slhowe/Spiro/python/shuttering/shuttering_HFU_trial/images/IMG_20190321_174952.jpg

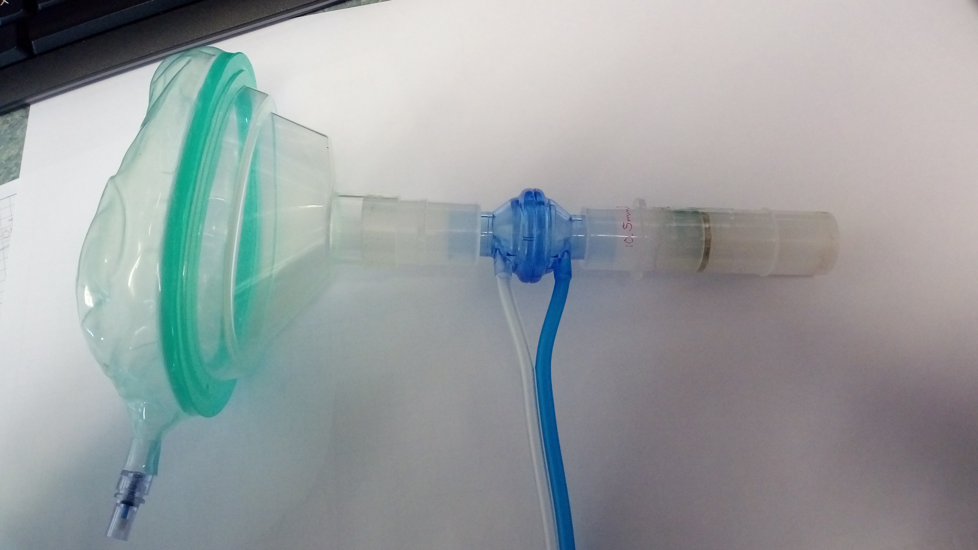
python/shuttering/shuttering_HFU_trial/images/IMG_20190321_174952.jpg
