slhowe/Spiro/spirometer_design/Spiro/spiroBoardV2/spiroBoardV2.html

# /home/sarah/Documents/Spirometry/spirometer_design/Spiro/spiroBoardV2/spiroBoardV2.sch

Tue 10 Sep 2019 03:00:49 PM NZST

Eeschema 5.1.4

Component Count:58

Ref | Qnty | Value | Part | Datasheet | Description | Vendor
C1 | 1 | 10n | Device:C | ~ | Unpolarized capacitor
C2 | 1 | 10uF | Device:C | ~ | Unpolarized capacitor
C3, C4 | 2 | 1uF | Device:C | ~ | Unpolarized capacitor
C5, C7, C8, C14, C15 | 5 | 0.1uF | Device:C | ~ | Unpolarized capacitor
C6 | 1 | 0.01uF | Device:C | ~ | Unpolarized capacitor
C9 | 1 | 22uF | Device:C | ~ | Unpolarized capacitor
C10, C11 | 2 | 100nF | Device:C | ~ | Unpolarized capacitor
C12, C13 | 2 | 22pF | Device:C | ~ | Unpolarized capacitor
Csuper1, Csuper2 | 2 | 1F | Device:CP1 | ~ | Polarized capacitor, US symbol
D1 | 1 | 3A 100V 0.4dV | Device:D | ~ | Diode
D2 | 1 | D_Schottky | Device:D_Schottky | ~ | Schottky diode
D3, D4 | 2 | LED | Device:LED | ~ | Light emitting diode
FB1, FB2 | 2 | Ferrite_Bead | Device:Ferrite_Bead | ~ | Ferrite bead
H1, H2, H3, H4 | 4 | MountingHole | Mechanical:MountingHole | ~ | Mounting Hole without connection
J1 | 1 | Barrel_Jack_Switch | Connector:Barrel_Jack_Switch | ~ | DC Barrel Jack with an internal switch
J2 | 1 | USB_B_Mini | Connector:USB_B_Mini | ~ | USB Mini Type B connector
J3 | 1 | Screw_Terminal_01x02 | Connector:Screw_Terminal_01x02 | ~ | Generic screw terminal, single row, 01x02, script generated (kicad-library-utils/schlib/autogen/connector/)
J4 | 1 | Conn_01x18_Female | Connector:Conn_01x18_Female | ~ | Generic connector, single row, 01x18, script generated (kicad-library-utils/schlib/autogen/connector/)
J5 | 1 | Conn_02x03_Odd_Even | Connector_Generic:Conn_02x03_Odd_Even | ~ | Generic connector, double row, 02x03, odd/even pin numbering scheme (row 1 odd numbers, row 2 even numbers), script generated (kicad-library-utils/schlib/autogen/connector/)
JP1 | 1 | Jumper_2_Bridged | Jumper:Jumper_2_Bridged | ~ | Jumper, 2-pole, closed/bridged
L1 | 1 | L_Core_Iron | Device:L_Core_Iron | ~ | Inductor with iron core
NMOS1 | 1 | 2N7002 | Transistor_FET:2N7002 | https://www.fairchildsemi.com/datasheets/2N/2N7002.pdf | 0.115A Id, 60V Vds, N-Channel MOSFET, SOT-23
PSH1 | 1 | ASDXRRX001PDAA5 | solenoidParts:ASDXRRX001PDAA5
PSL1 | 1 | SSCSNBN001NDAA5 | solenoidParts:SSCSNBN001NDAA5
R1 | 1 | 0.067 | Device:R | ~ | Resistor
R2, R9, R10 | 3 | 1K | Device:R | ~ | Resistor
R3, R5 | 2 | 8 | Device:R | ~ | Resistor
R4 | 1 | 160 | Device:R | ~ | Resistor
R6 | 1 | 300 | Device:R | ~ | Resistor
R7, R8 | 2 | 22 | Device:R | ~ | Resistor
R11 | 1 | 220 | Device:R | ~ | Resistor
R12 | 1 | 10K | Device:R | ~ | Resistor
RL1 | 1 | 250k | Device:R | ~ | Resistor
SW1 | 1 | SW_Push_Open | Switch:SW_Push_Open | ~ | Push button switch, push-to-open, generic, two pins
SW2 | 1 | SW_Push | Switch:SW_Push | ~ | Push button switch, generic, two pins
U1 | 1 | INA168 | Amplifier_Current:INA168 | http://www.ti.com/lit/ds/symlink/ina138.pdf | High-Side Measurement Current Shunt Monitor, 60V, SOT-23-5
U2 | 1 | OPA340NA | Amplifier_Operational:OPA340NA | http://www.ti.com/lit/ds/symlink/opa340.pdf | Single Single-Supply, Rail-to-Rail Operational Amplifier, MicroAmplifier Series, SOT-23-5
U3 | 1 | ZTX690B-ND | solenoidParts:ZTX690B-ND
U4 | 1 | RT9261A-50GB | solenoidParts:RT9261A-50GB
U5 | 1 | ATmega32U4-MU | MCU_Microchip_ATmega:ATmega32U4-MU | http://ww1.microchip.com/downloads/en/DeviceDoc/Atmel-7766-8-bit-AVR-ATmega16U4-32U4_Datasheet.pdf | 16MHz, 32kB Flash, 2.5kB SRAM, 1kB EEPROM, USB 2.0, QFN-44
Y1 | 1 | 16MHz | Device:Crystal | ~ | Two pin crystal
