slhowe/Spiro/spirometer_design/NewFile2.csv

X | CH1 | CH2 | CH3 | Start | Increment
Sequence | Volt | Volt | Volt | -4.120000e-02 | 2.000000e-04
0 | 1.22e+01 | 1.20e+00 | -1.60e-01
1 | 1.18e+01 | 1.00e+00 | 8.00e-02
2 | 1.22e+01 | 1.20e+00 | 8.00e-02
3 | 1.18e+01 | 1.00e+00 | -1.60e-01
4 | 1.26e+01 | 1.20e+00 | 8.00e-02
5 | 1.14e+01 | 1.00e+00 | -1.60e-01
6 | 1.26e+01 | 1.20e+00 | -8.00e-02
7 | 1.16e+01 | 1.00e+00 | 8.00e-02
8 | 1.18e+01 | 1.20e+00 | 8.00e-02
9 | 1.22e+01 | 1.00e+00 | -1.60e-01
10 | 1.18e+01 | 1.20e+00 | -1.60e-01
11 | 1.22e+01 | 1.00e+00 | 8.00e-02
12 | 1.22e+01 | 1.00e+00 | 8.00e-02
13 | 1.18e+01 | 1.20e+00 | -1.60e-01
14 | 1.22e+01 | 1.20e+00 | 8.00e-02
15 | 1.18e+01 | 1.00e+00 | -1.60e-01
16 | 1.26e+01 | 1.20e+00 | 8.00e-02
17 | 1.14e+01 | 1.00e+00 | -1.60e-01
18 | 1.22e+01 | 1.20e+00 | 8.00e-02
19 | 1.18e+01 | 1.00e+00 | -1.60e-01
20 | 1.22e+01 | 1.00e+00 | 8.00e-02
21 | 1.18e+01 | 1.20e+00 | -1.60e-01
22 | 1.22e+01 | 1.20e+00 | 8.00e-02
23 | 1.18e+01 | 1.00e+00 | -1.60e-01
24 | 1.22e+01 | 1.20e+00 | 8.00e-02
25 | 1.16e+01 | 1.00e+00 | -1.60e-01
26 | 1.14e+01 | 1.20e+00 | -8.00e-02
27 | 1.26e+01 | 1.00e+00 | 8.00e-02
28 | 1.22e+01 | 1.20e+00 | -1.60e-01
29 | 1.18e+01 | 1.00e+00 | 8.00e-02
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
