slhowe/Spiro/python/shuttering/shuttering_HFU_trial/images/all_shutters.png

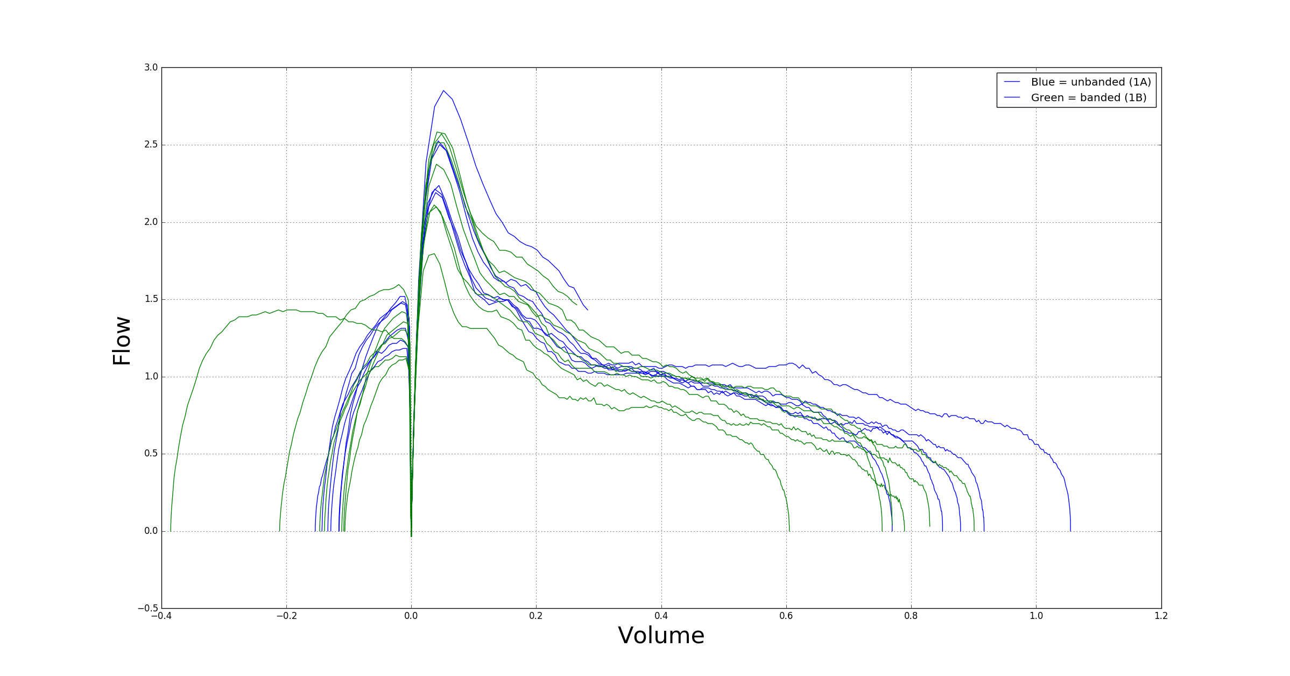
python/shuttering/shuttering_HFU_trial/images/all_shutters.png
