slhowe/Spiro/python/shuttering/shuttering_HFU_trial/images/all_shutters_norm.png

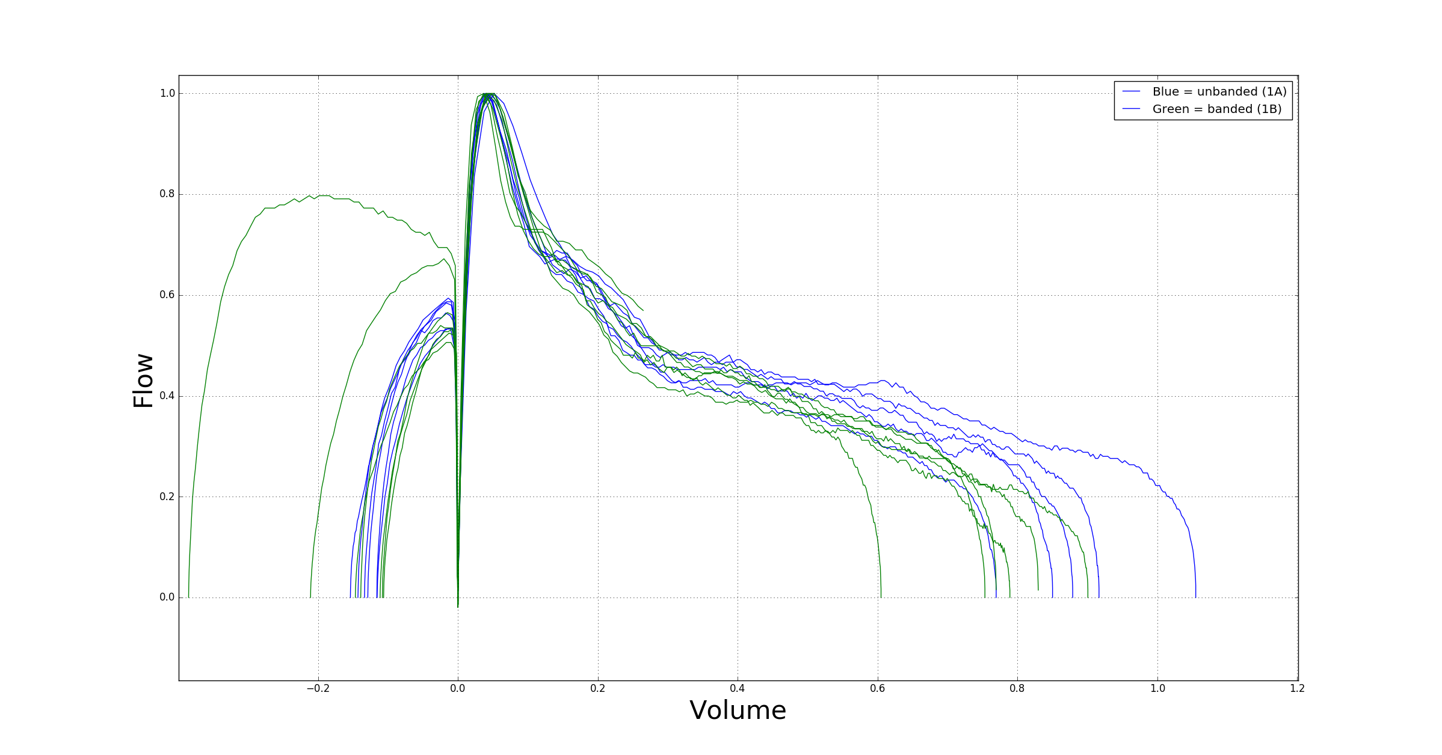
python/shuttering/shuttering_HFU_trial/images/all_shutters_norm.png
