slhowe/Spiro/python/shuttering/shuttering_HFU_trial/images/IMG_20190321_175017.jpg

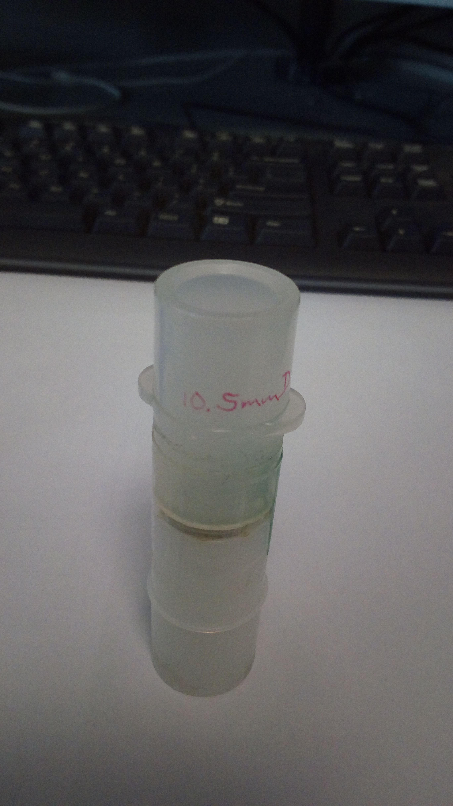
python/shuttering/shuttering_HFU_trial/images/IMG_20190321_175017.jpg
