slhowe/Spiro/python/shuttering/shuttering_HFU_trial/images/messy.png

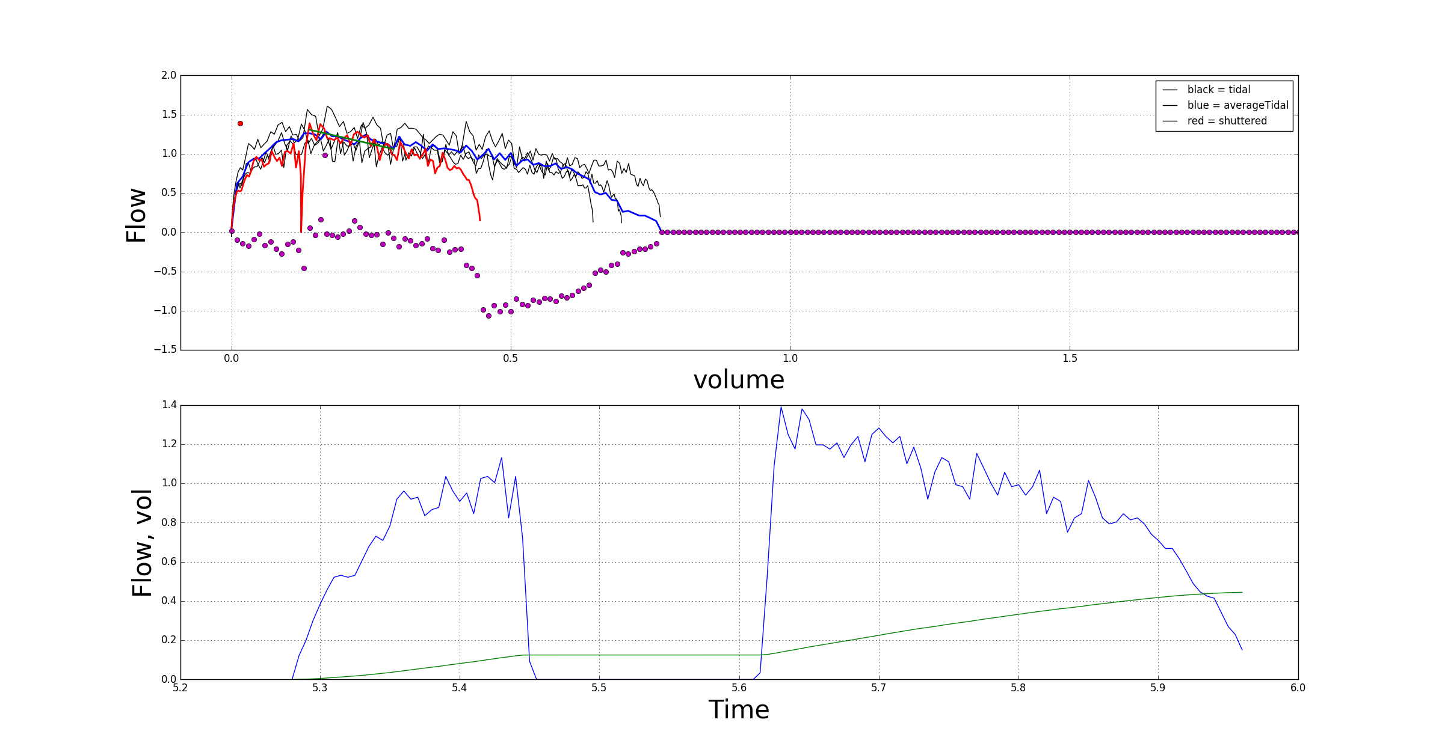
python/shuttering/shuttering_HFU_trial/images/messy.png
