slhowe/Spiro/python/shuttering/shuttering_HFU_trial/images/missingVolume.png

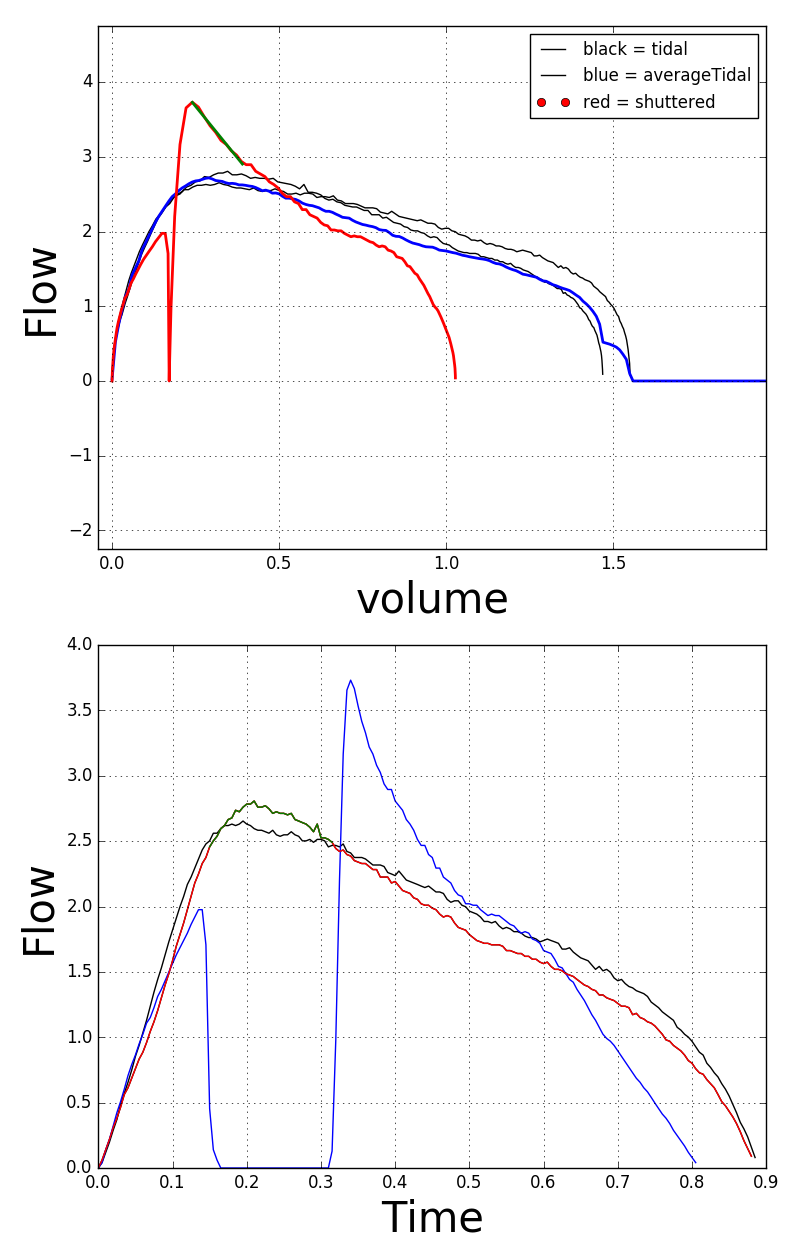
python/shuttering/shuttering_HFU_trial/images/missingVolume.png
