slhowe/Spiro/python/shuttering/shuttering_HFU_trial/images/nice.png

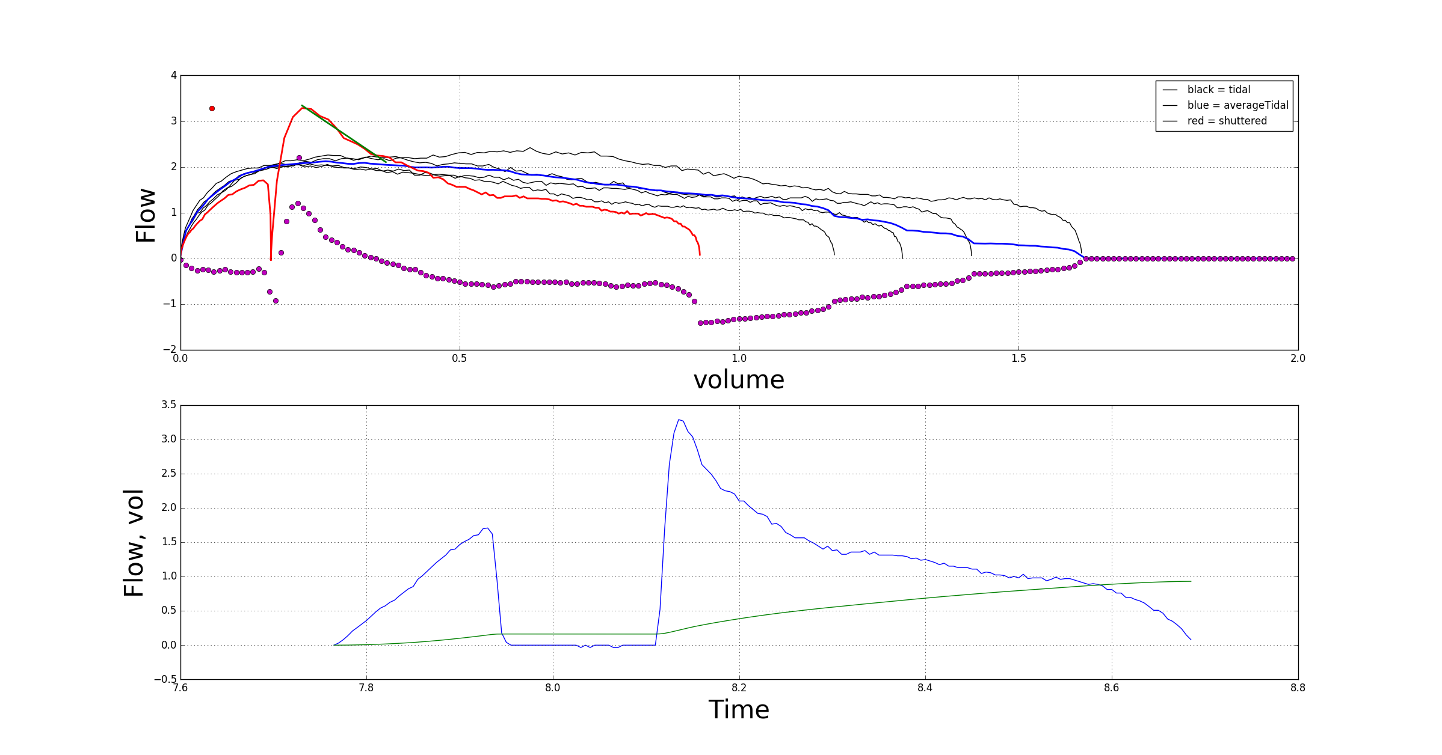
python/shuttering/shuttering_HFU_trial/images/nice.png
