slhowe/Spiro/python/shuttering/shuttering_HFU_trial/images/plethysmography_sparce.png

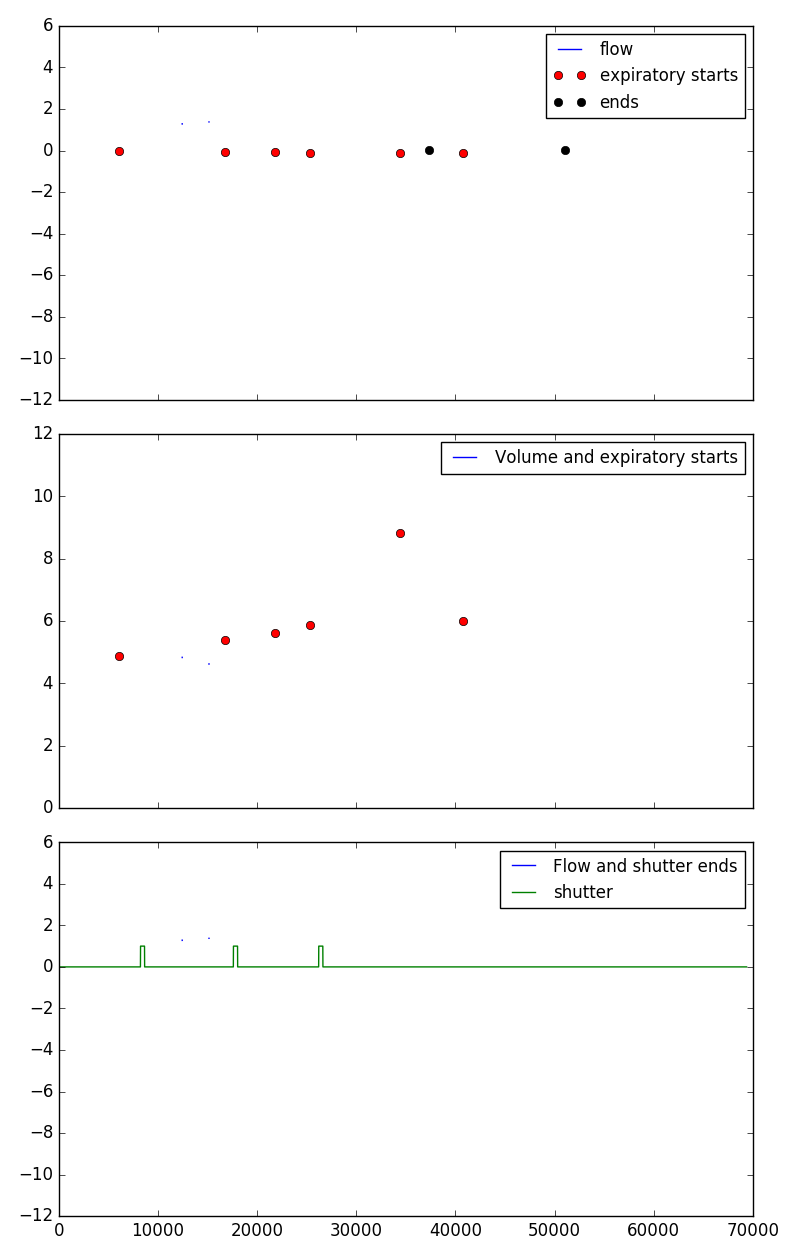
python/shuttering/shuttering_HFU_trial/images/plethysmography_sparce.png
