slhowe/Spiro/python/shuttering/shuttering_HFU_trial/images/shutter_example2.png

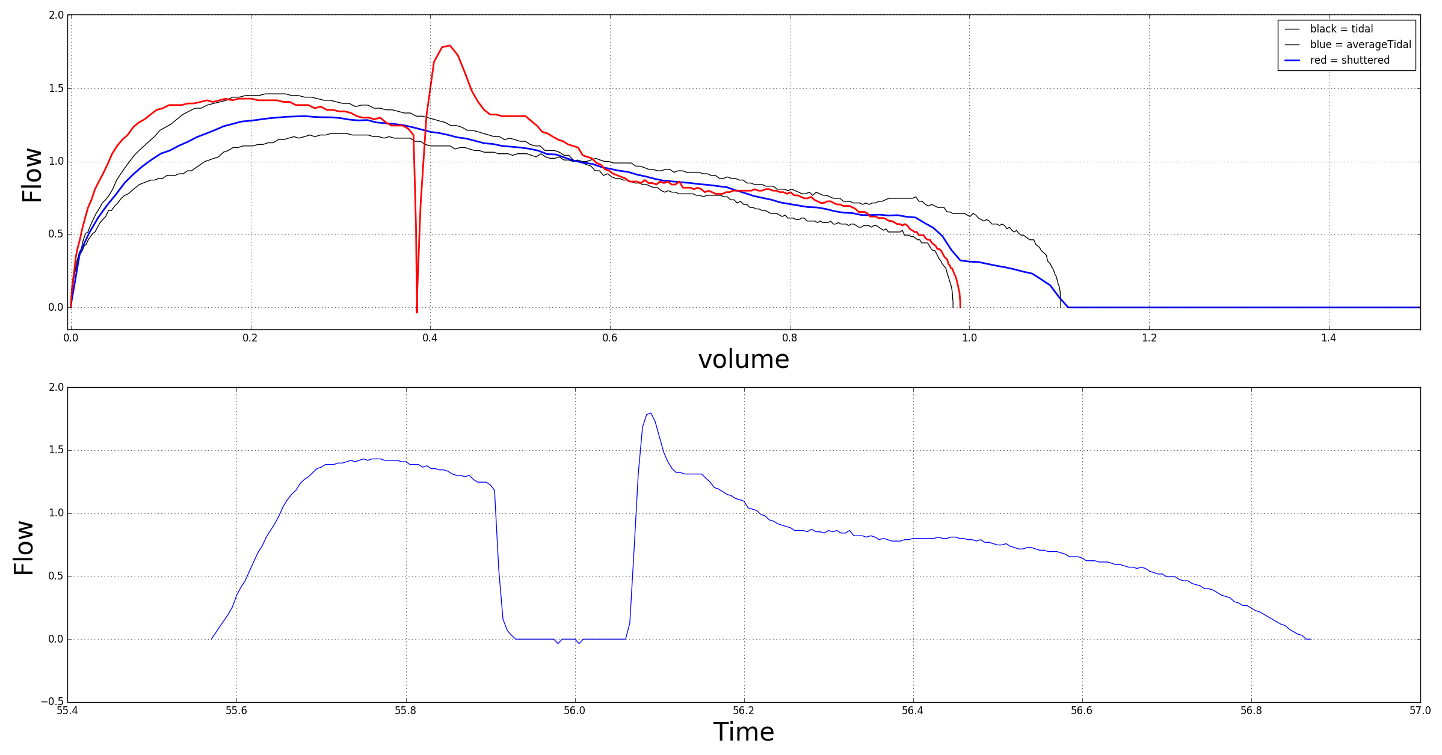
python/shuttering/shuttering_HFU_trial/images/shutter_example2.png
