slhowe/Spiro/python/shuttering/shuttering_HFU_trial/images/shutter_example3.png

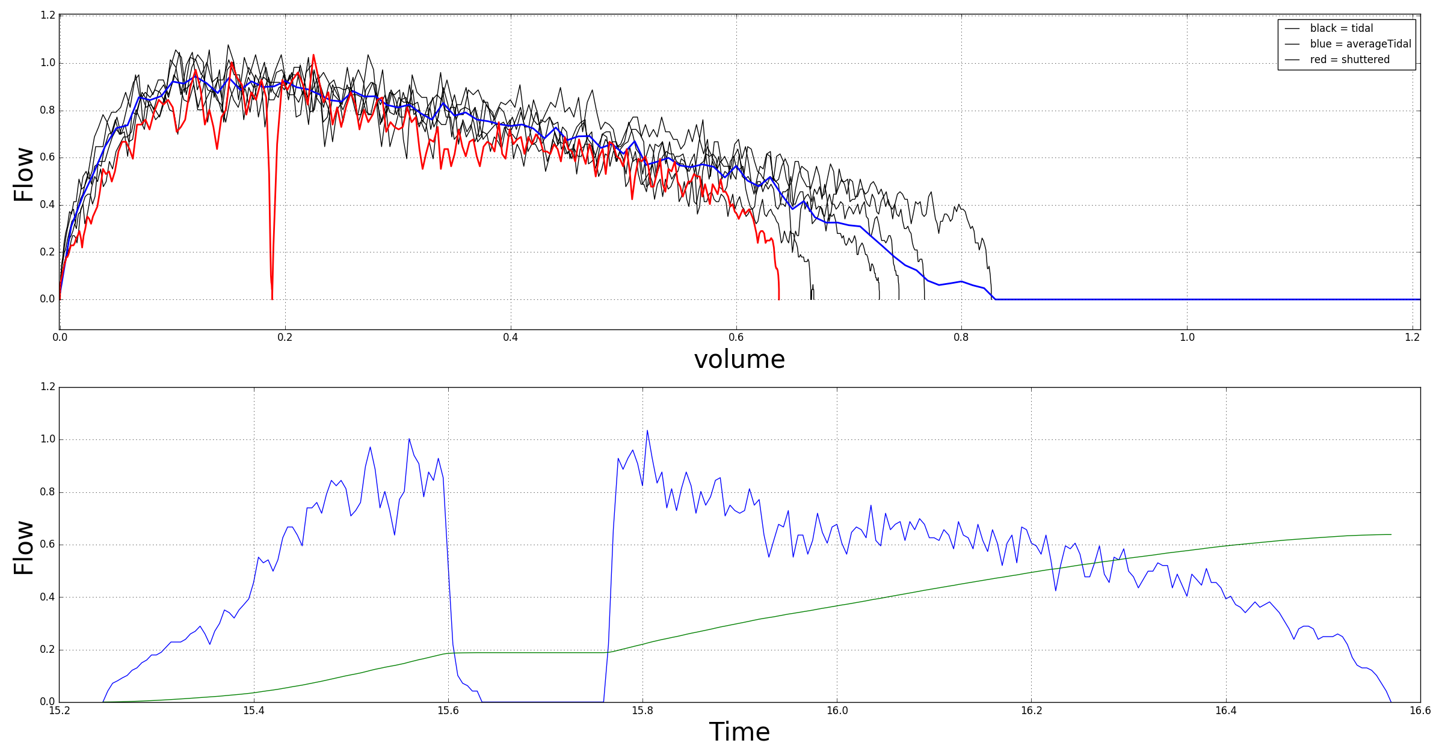
python/shuttering/shuttering_HFU_trial/images/shutter_example3.png
