slhowe/Spiro/python/shuttering/shuttering_HFU_trial/images/shutter_example.png

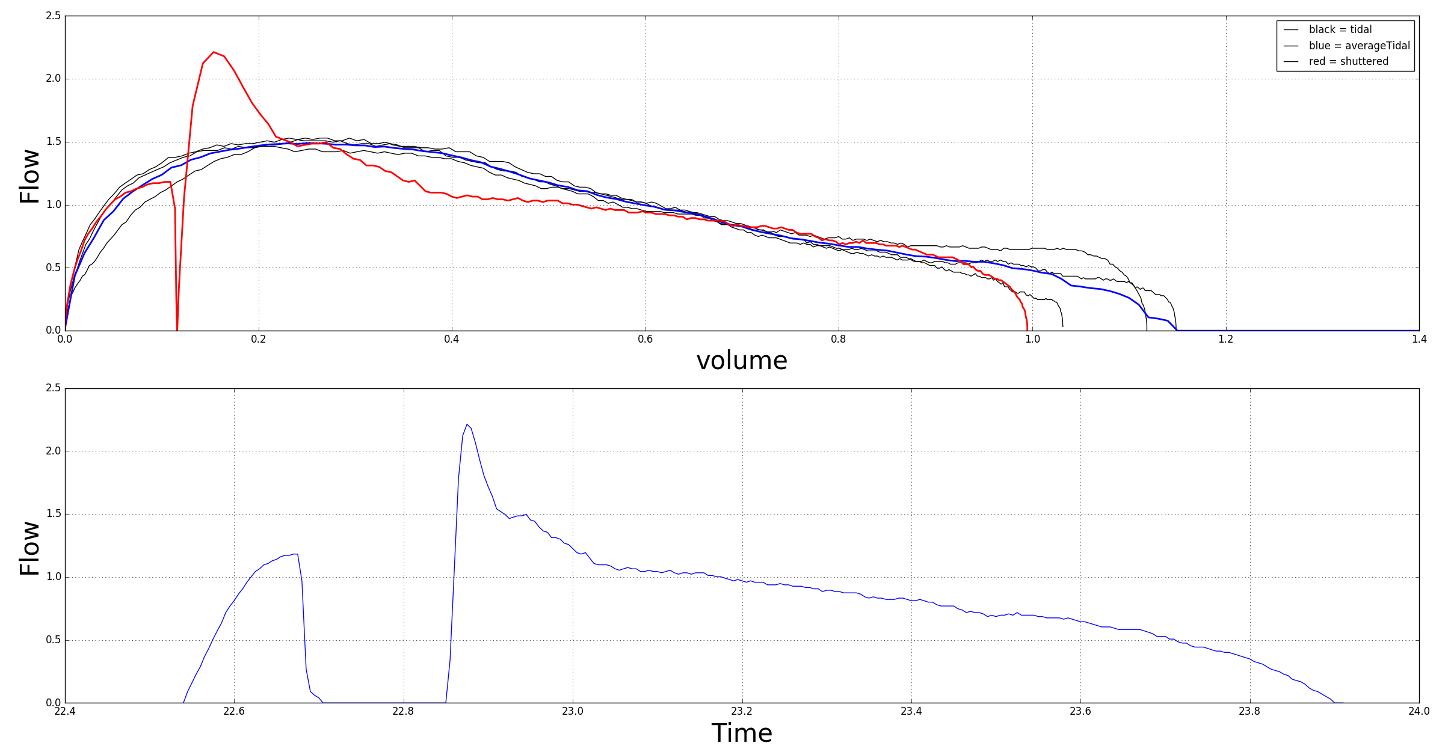
python/shuttering/shuttering_HFU_trial/images/shutter_example.png
