slhowe/Spiro/python/shuttering/simulation/QV_loops.png

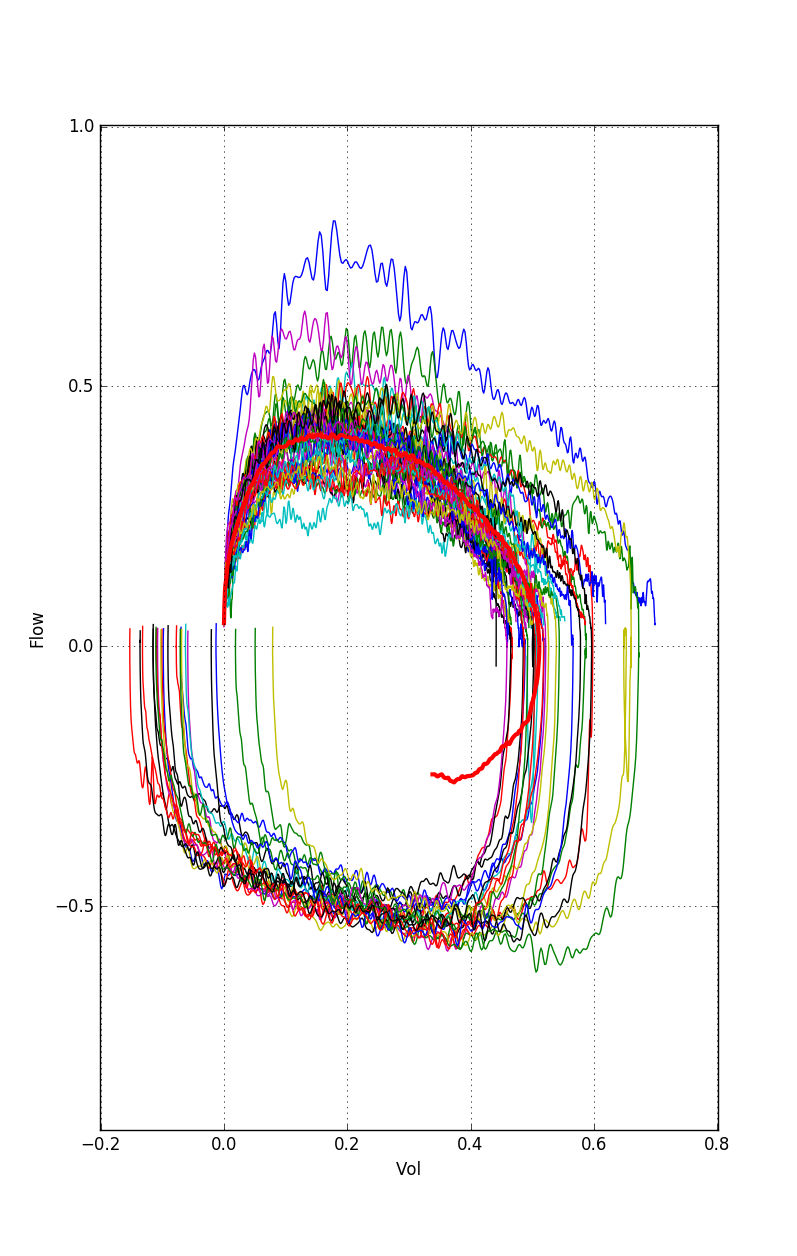
python/shuttering/simulation/QV_loops.png
