slhowe/Spiro/spirometer_design/jake_small/digQuote.xls

Digi-Key Part Number | Manufacturer | Manufacturer Part Number | Description | Customer Reference | Quantity 1 | Price | Comp total | Quantity 2 | Price | Comp total | Quantity 3 | Price | Comp total | Stock Status | Mfg Std Lead Time | Comments | RoHS Status | Lead Free Status | REACH Status | US Tariff Status
ATTINY167-MU-ND | MICROCHIP TECHNOLOGY | ATTINY167-MU | IC MCU 8BIT 16KB FLASH 32VQFN |  | 2 | 1.57 | 3.14 | 10 | 1.57 | 15.7 | 50 | 1.4316 | 71.58 | IN STOCK | 4 Weeks | Alternate Packaging Exists | RoHS Compliant | Lead free | Unaffected Jan-2017
SAM9428-ND | SAMTEC INC | FTSH-104-01-F-DV | .050" X .050 TERMINAL STRIP |  | 4 | 1.36 | 5.44 | 20 | 1.235 | 24.7 | 100 | 1.235 | 123.5 | IN STOCK | 3 Weeks | Alternate Packaging Exists | RoHS Compliant | Lead free | Unaffected Jan-2017
1497-1371-1-ND | SUNLED COMPANY LLC (VA) | XZM2MRTNI55W-8 | LED RED CLEAR 4SMD |  | 8 | 1.42 | 11.36 | 40 | 0.8844 | 35.376 | 200 | 0.7961 | 159.22 | IN STOCK | 6 Weeks | Alternate Packaging Exists | RoHS Compliant | Lead free | Unaffected Jan-2017 | Tariff Applied
160-1827-1-ND | LITE-ON INC (VA) | LTST-C193TBKT-5A | LED BLUE CLEAR CHIP SMD |  | 2 | 0.17 | 0.34 | 10 | 0.336 | 3.36 | 50 | 0.2572 | 12.86 | IN STOCK | 12 Weeks | Alternate Packaging Exists | RoHS Compliant | Lead free | Not Available | Tariff Applied
1276-1012-1-ND | SAMSUNG ELECTRO-MECHANICS AMERICA, INC (VA) | CL10F104ZB8NNNC | CAP CER 0.1UF 50V Y5V 0603 |  | 2 | 0.1 | 0.2 | 10 | 0.038 | 0.38 | 50 | 0.038 | 1.9 | 1692092 IN STOCK/NO DELIVERY DATE AVAILABLE | 62 Weeks | No delivery date available | RoHS Compliant | Lead free | Unaffected Jul-2017
478-1556-1-ND | AVX CORPORATION (VA) | 12065C104KAT2A | CAP CER 0.1UF 50V X7R 1206 |  | 2 | 0.3 | 0.6 | 10 | 0.205 | 2.05 | 50 | 0.205 | 10.25 | IN STOCK | 30 Weeks | Alternate Packaging Exists | RoHS Compliant | Lead free | Unaffected Jul-2017 | Tariff Applied
A106145CT-ND | TE CONNECTIVITY AMP (VA) | RCU-0C | PC TEST POINT NATURAL |  | 4 | 0.22 | 0.88 | 20 | 0.211 | 4.22 | 100 | 0.1462 | 14.62 | IN STOCK | 7 Weeks | Alternate Packaging Exists | RoHS Compliant | Lead free | Not Available
P300LCT-ND | PANASONIC ELECTRONIC COMPONENTS (VA) | ERJ-2RKF3000X | RES SMD 300 OHM 1% 1/10W 0402 |  | 2 | 0.1 | 0.2 | 10 | 0.054 | 0.54 | 50 | 0.054 | 2.7 | IN STOCK | 18 Weeks | Alternate Packaging Exists | RoHS Compliant | Lead free | Unaffected Jan-2017 | Tariff Applied
P115DBCT-ND | PANASONIC ELECTRONIC COMPONENTS (VA) | ERA-3AEB1150V | RES SMD 115 OHM 0.1% 1/10W 0603 | R5, R7 | 4 | 0.35 | 1.4 | 20 | 0.3 | 6 | 100 | 0.1172 | 11.72 | IN STOCK | 23 Weeks | Alternate Packaging Exists | RoHS Compliant | Lead free | Unaffected Jan-2017
P69.8DBCT-ND | PANASONIC ELECTRONIC COMPONENTS (VA) | ERA-3AEB69R8V | RES SMD 69.8 OHM 0.1% 1/10W 0603 | R6, R9 | 4 | 0.35 | 1.4 | 20 | 0.3 | 6 | 100 | 0.1172 | 11.72 | IN STOCK | 23 Weeks | Alternate Packaging Exists | RoHS Compliant | Lead free | Unaffected Jan-2017
 |  |  |  |  |  | Total: | 24.96 |  | Total: | 98.326 |  | Total: | 420.07
 |  |  |  |  |  | $/board | 12.48 |  | $/board | 9.8326 |  | $/board | 8.4014
 |  |  |  |  |  |  | 200 | 0.7961 | 159.22
 |  |  |  |  |  |  | 350 | 0.70768 | 247.688
