slhowe/Spiro/spirometer_design/jake_small/jake_small_holder.stl

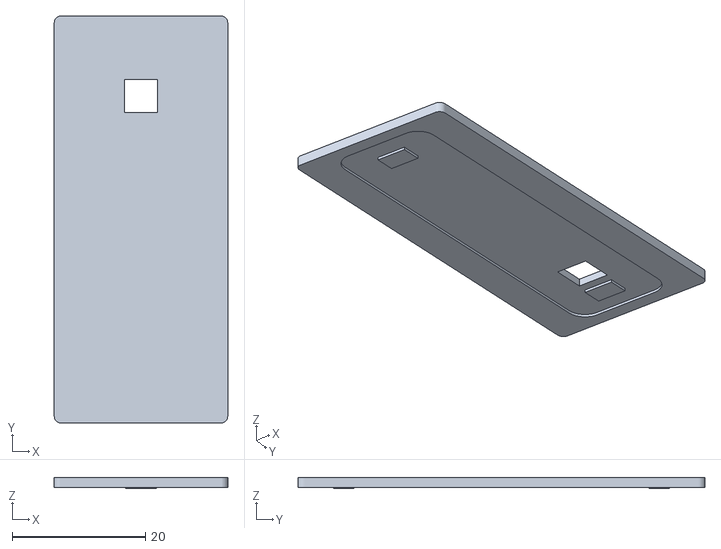
[picture p14: CAD file, 2020-03-23]
spirometer_design/jake_small/jake_small_holder.stl
26.0 x 61.0 x 1.70
