slhowe/Spiro/spirometer_design/jake_small/jake_small_holder.scad

bX = 13;
bY = 54;

holeX = 8;
holeY = 3.5;

dHoleY = 47;

roundedRect([bX, bY, 0.4], 2.5);
module roundedRect(size, radius)
{
x = size[0];
y = size[1];
z = size[2];

linear_extrude(height=z)
hull()
{
    // place 4 circles in the corners, with the given radius
    translate([(-x/2)+(radius/2), (-y/2)+(radius/2), 0])
    circle(r=radius);

    translate([(x/2)-(radius/2), (-y/2)+(radius/2), 0])
    circle(r=radius);

    translate([(-x/2)+(radius/2), (y/2)-(radius/2), 0])
    circle(r=radius);

    translate([(x/2)-(radius/2), (y/2)-(radius/2), 0])
    circle(r=radius);
}

}
