slhowe/Spiro/python/shuttering/shuttering_HFU_trial/data/HFU_Respiratory_Trial/P1-JGC-18032019/Test Sequence Run Sheet ver 1.0.xlsx

Sheet: Run Ver 1A
Test sequence run sheet
Baseline: steady breathing to get FRC and Rspecific resistance
Standard-XX: Forced expiration tests of N=3 good examples with additions as noted. Yields FEV1 and FVC as well
Shutter-XX: Normal breathing with 150ms shuttering in expiration (1st second) as only speed possible, with additions as noted
Additions: band and/or added resistance
 |  |  | = added resistance
 |  |  | = nominal resistance
 |  |  |  | = nominal compliance
 |  |  |  | = added band and reduced compliance
 | Baseline
 | Standard-1A | no additions
 | Baseline
 | Standard-1B | with band
 | Baseline
 | Standard-2A | with band and added resistance
 | Baseline
 | Standard-2B | added resistance
 | Baseline
 | Shutter-2B | with added resistance
 | Baseline
 | Shutter-2A | with band and added resistance
 | Baseline
 | Shutter-1B | with band
 | Baseline
 | Shutter-1A | no additions

Sheet: Run Ver 1B
Test sequence run sheet
Baseline: steady breathing to get FRC and Rspecific resistance
Standard-XX: Forced expiration tests of N=3 good examples with additions as noted. Yields FEV1 and FVC as well
Shutter-XX: Normal breathing with 150ms shuttering in expiration (1st second) as only speed possible, with additions as noted
Additions: band and/or added resistance
 |  |  | = added resistance
 |  |  | = nominal resistance
 |  |  |  | = nominal compliance
 |  |  |  | = added band and reduced compliance
 | Baseline
 | Standard-1A | no additions
 | Baseline
 | Shutter-1A | no additions
 | Baseline
 | Standard-1B | with band
 | Baseline
 | Shutter-1B | with band
 | Baseline
 | Standard-2A | with band and added resistance
 | Baseline
 | Shutter-2A | with band and added resistance
 | Baseline
 | Standard-2B | added resistance
 | Baseline
 | Shutter-2B | with added resistance
