slhowe/Spiro/python/calibration/calibrationFiles/flip_spir_1.png

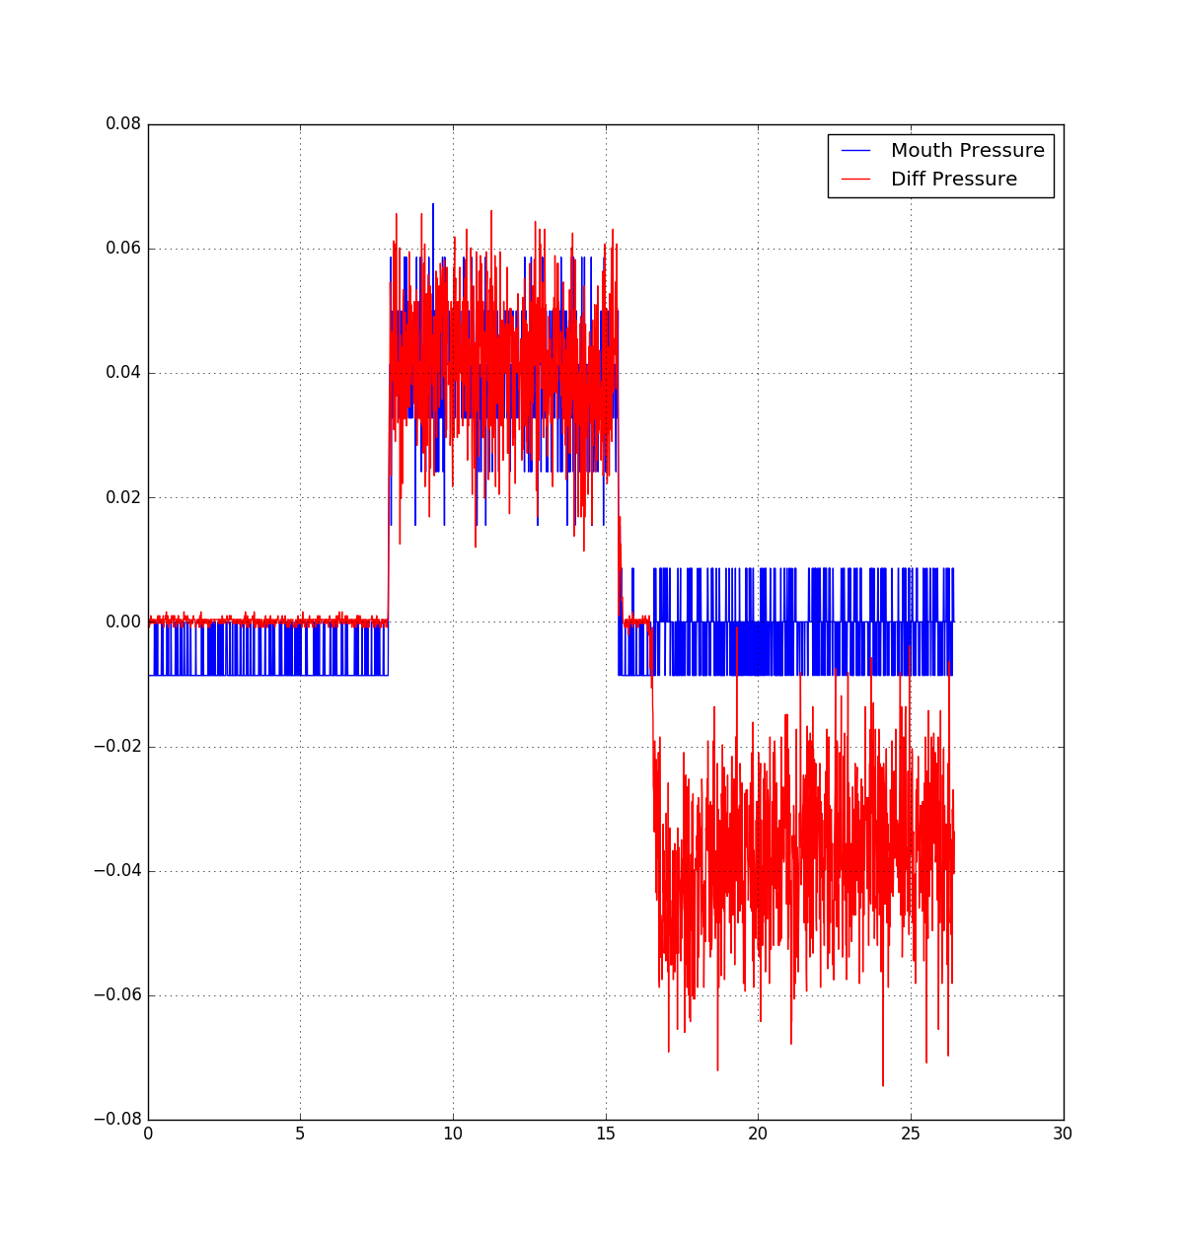
python/calibration/calibrationFiles/flip_spir_1.png
