slhowe/Spiro/python/calibration/calibrationFiles/flip_spir_2.png

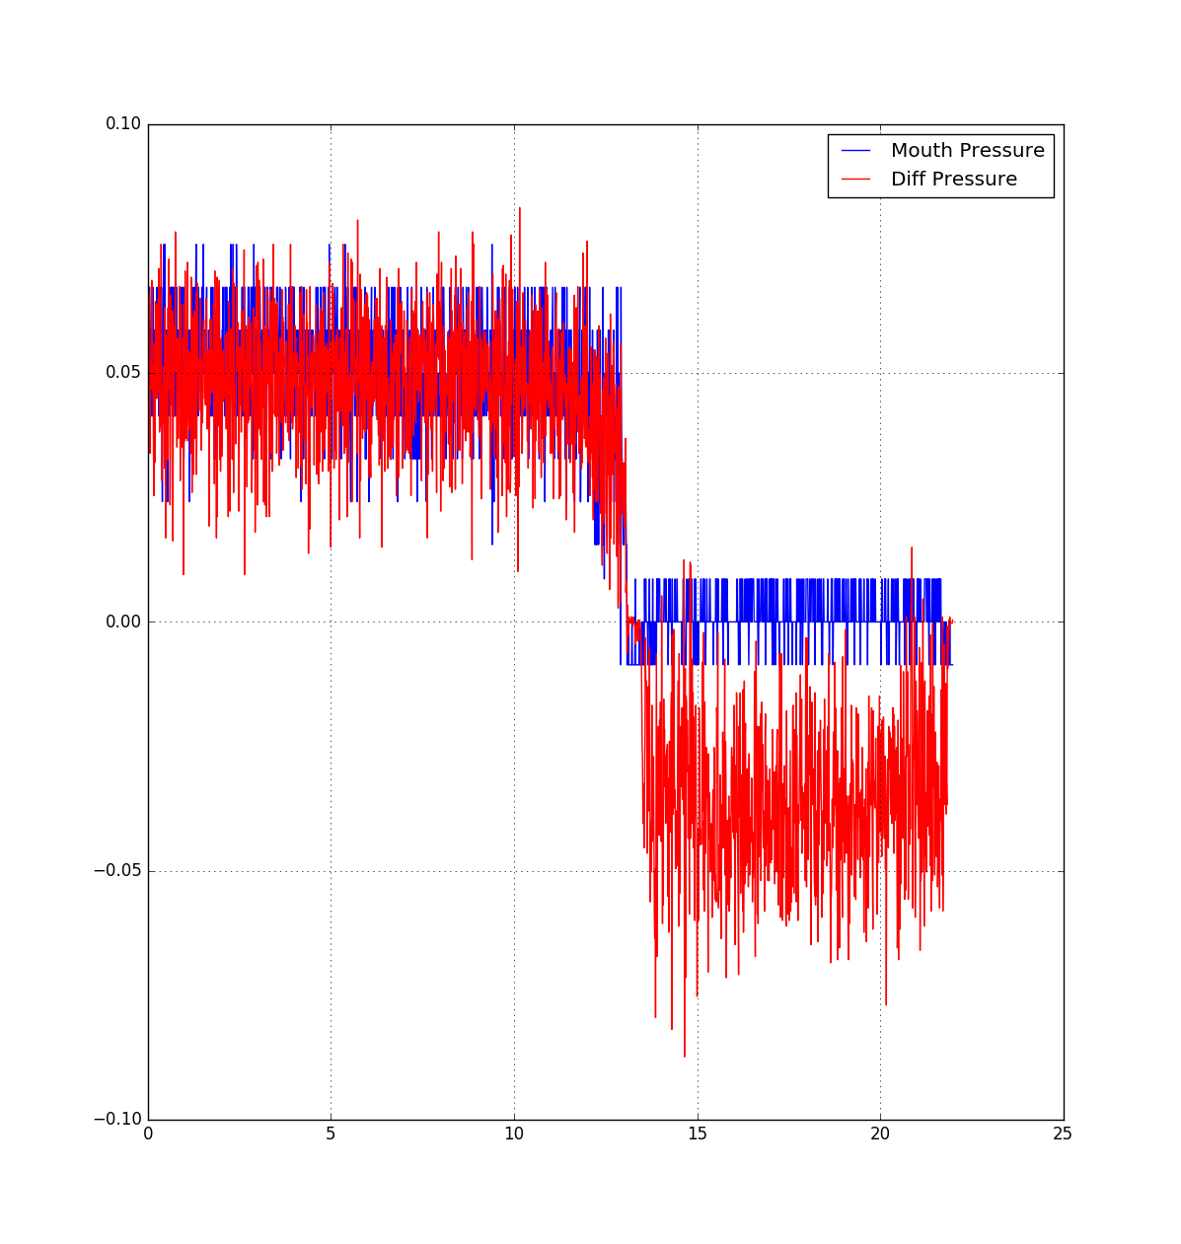
python/calibration/calibrationFiles/flip_spir_2.png
