slhowe/Spiro/python/calibration/calibrationFiles/flip_spir_3.png

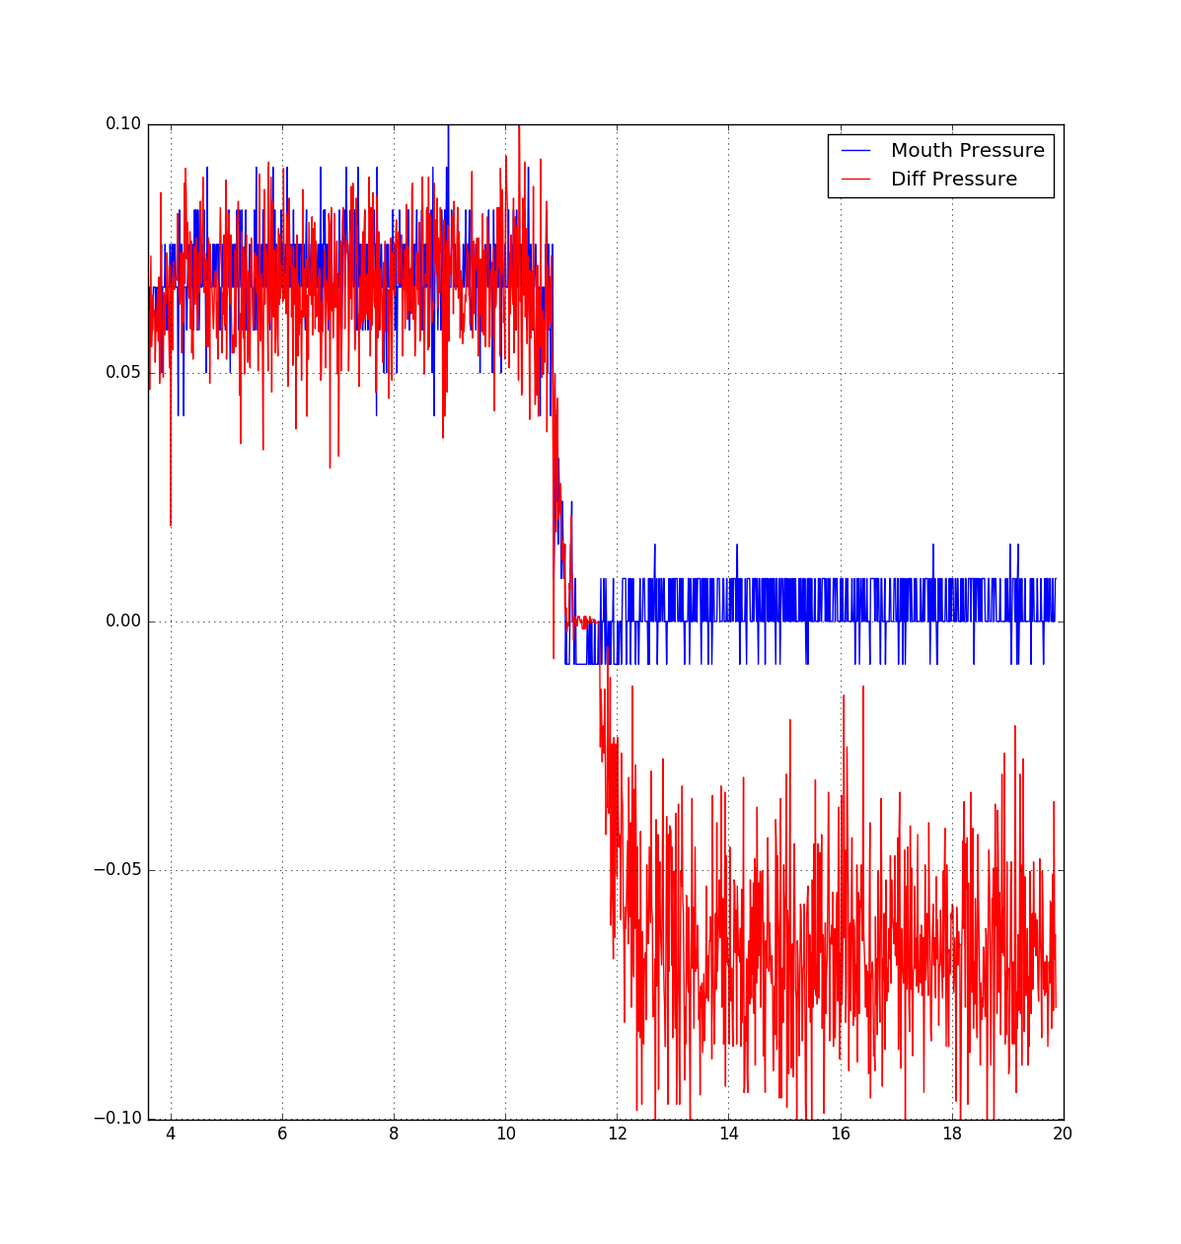
python/calibration/calibrationFiles/flip_spir_3.png
