slhowe/Spiro/python/shuttering/simulation/Germany_results_badfit.png

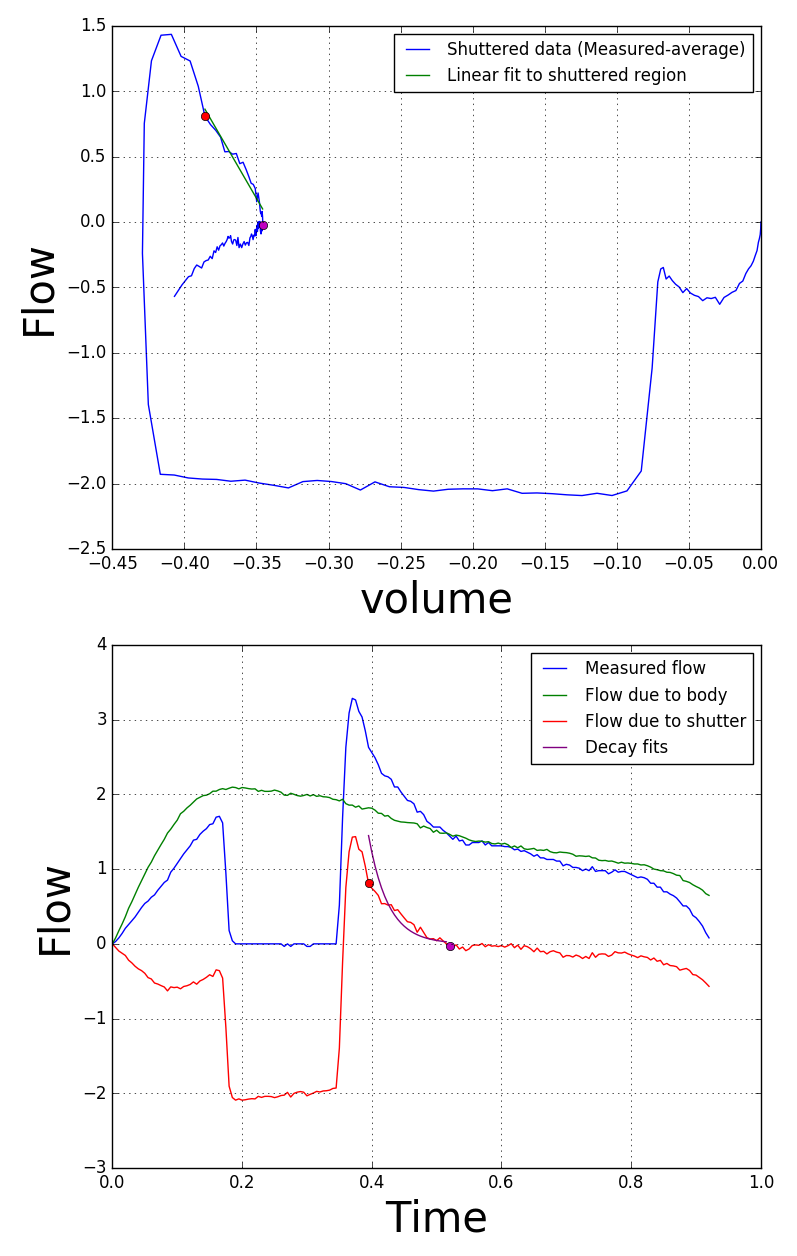
python/shuttering/simulation/Germany_results_badfit.png
