slhowe/Spiro/python/shuttering/simulation/Germany_results_betterfit.png

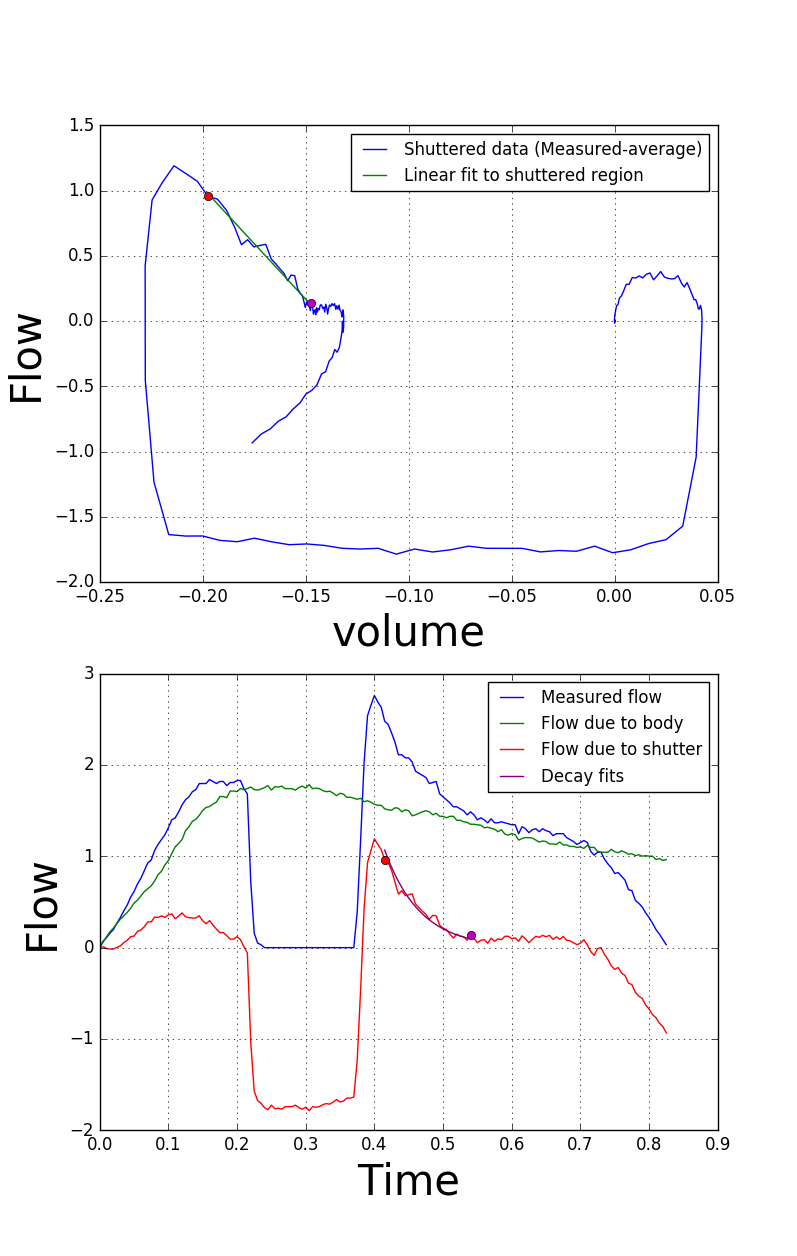
python/shuttering/simulation/Germany_results_betterfit.png
