slhowe/Spiro/python/shuttering/simulation/my_results.png

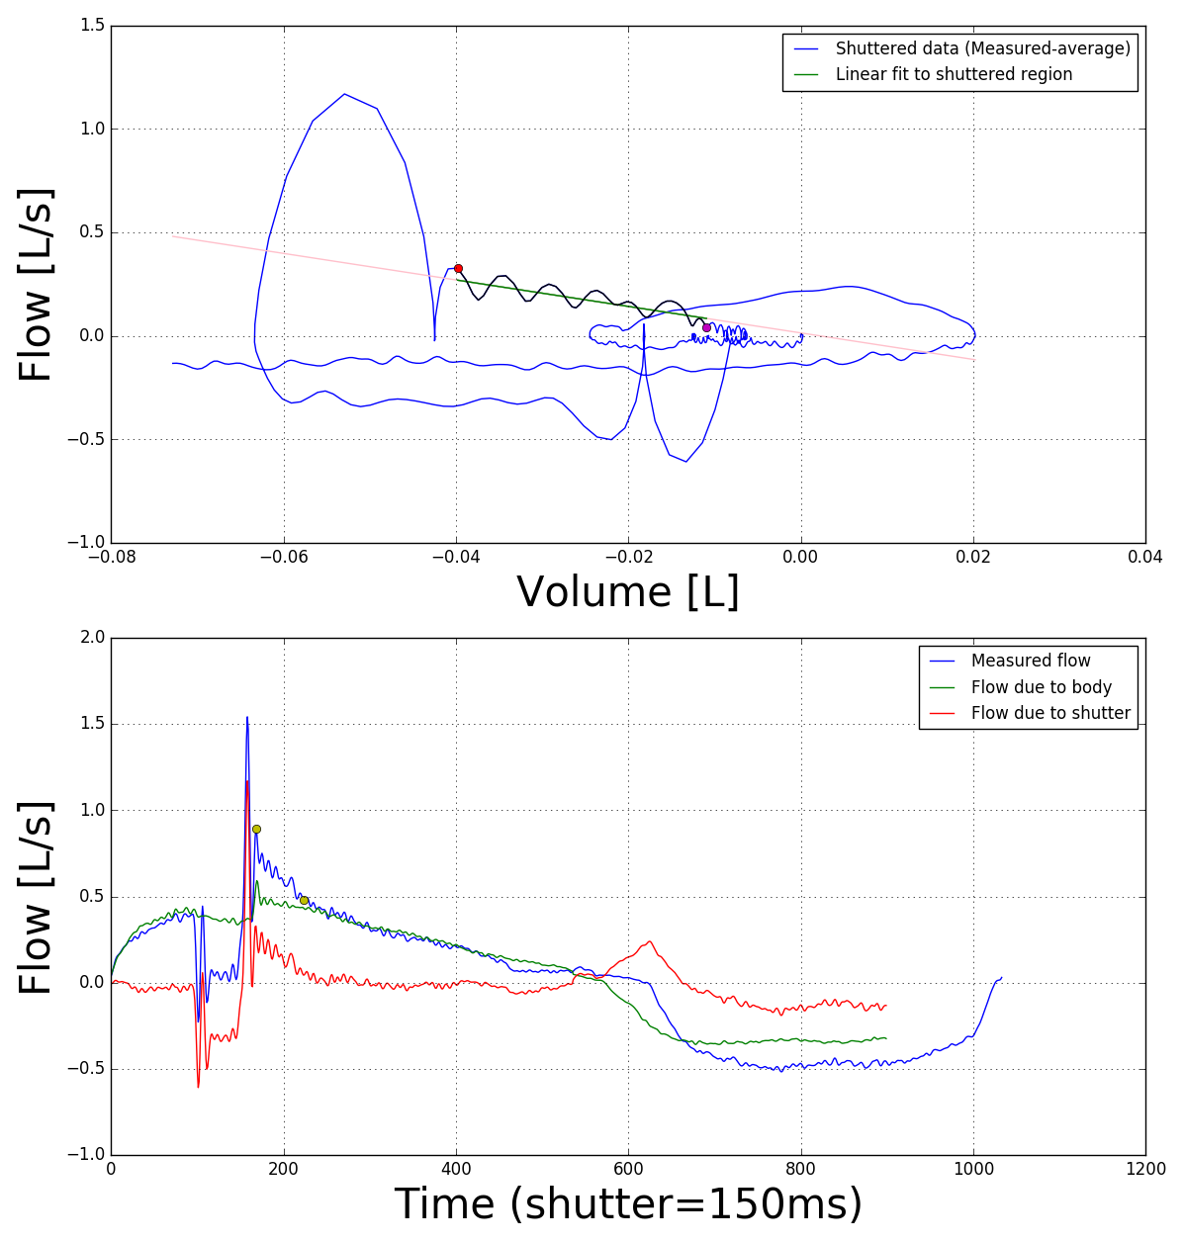
python/shuttering/simulation/my_results.png
