slhowe/Spiro/python/shuttering/simulation/Simulation_results.png

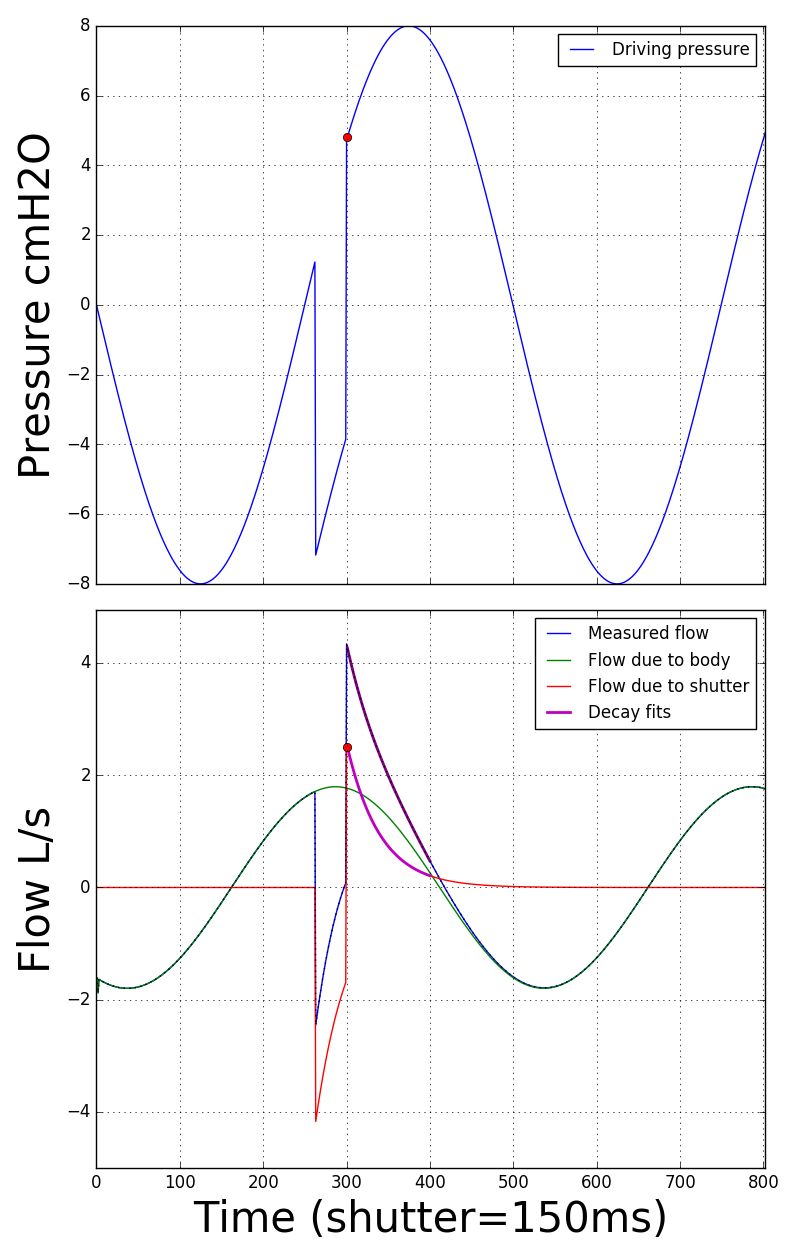
python/shuttering/simulation/Simulation_results.png
