slhowe/Spiro/python/shuttering/simulation/Simulation_results_QV.png

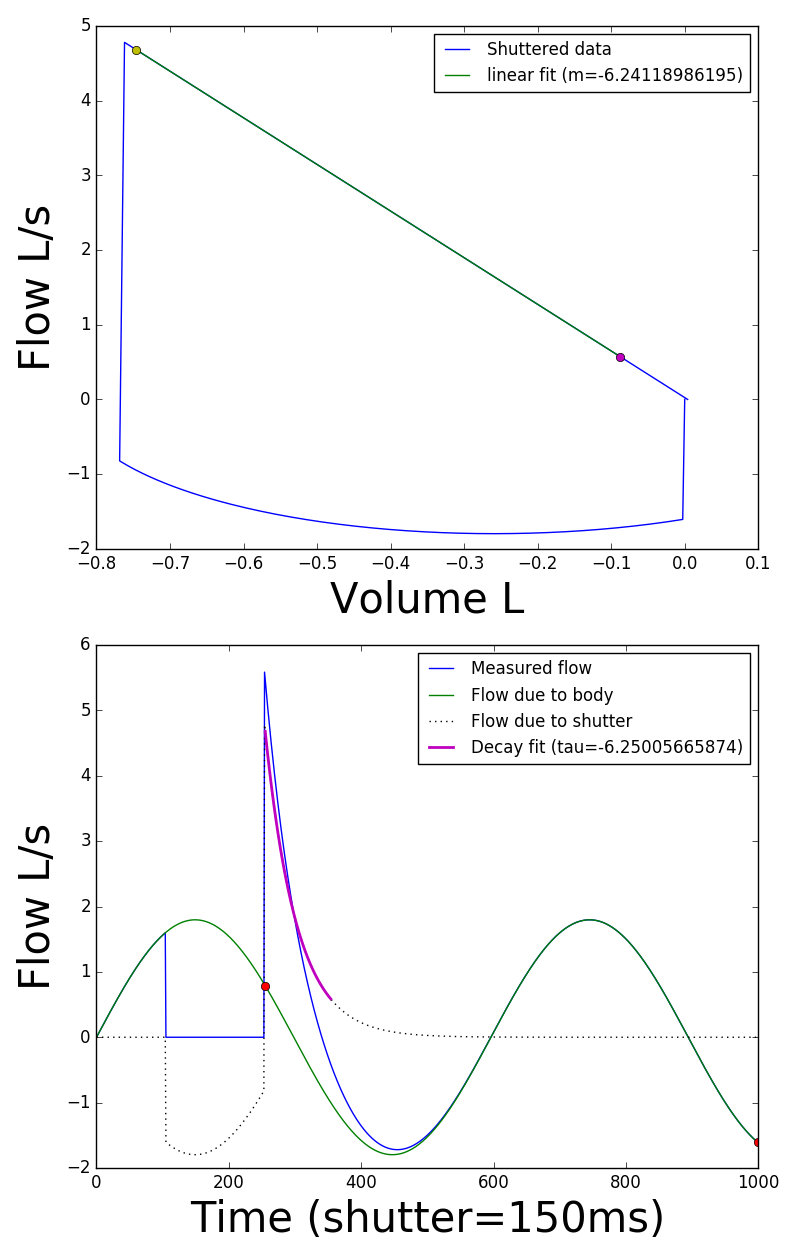
python/shuttering/simulation/Simulation_results_QV.png
