slhowe/Spiro/spirometer_design/jake_small/pdf/jake_small-F.SilkS.pdf

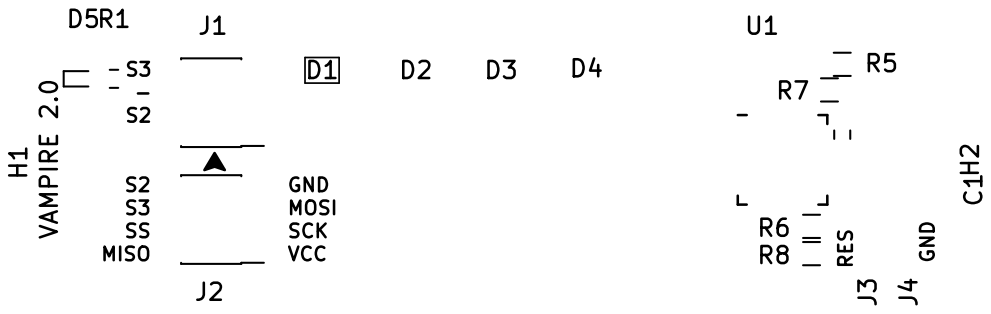
[picture p23: page 1]

RES GND D1 D2 D3 D4 GND MOSI SCK
