slhowe/Spiro/spirometer_design/jake_small/pdf/jake_small-B.Adhes.pdf

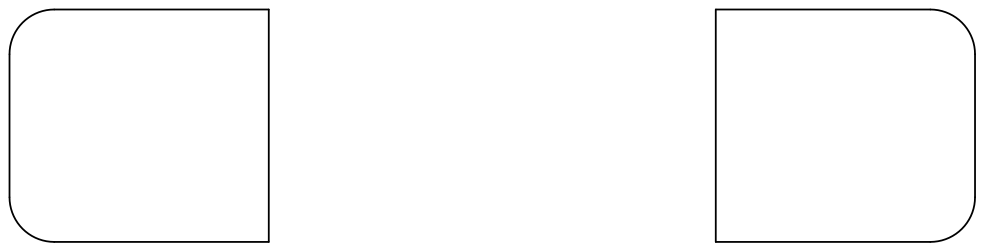
[picture p24: page 1]
