slhowe/Spiro/spirometer_design/jake_small/pdf/jake_small-B.Cu.pdf

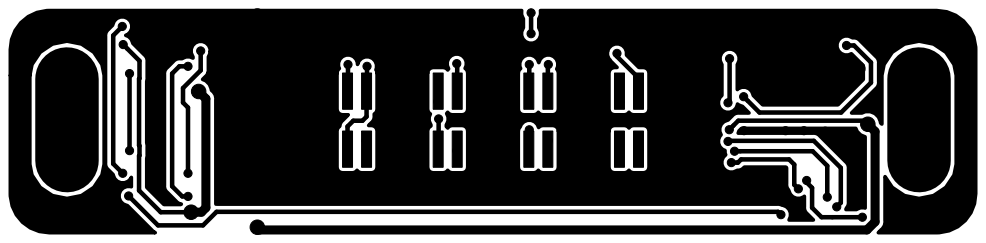
[picture p25: page 1]
