slhowe/Spiro/spirometer_design/jake_small/pdf/jake_small-B.Paste.pdf

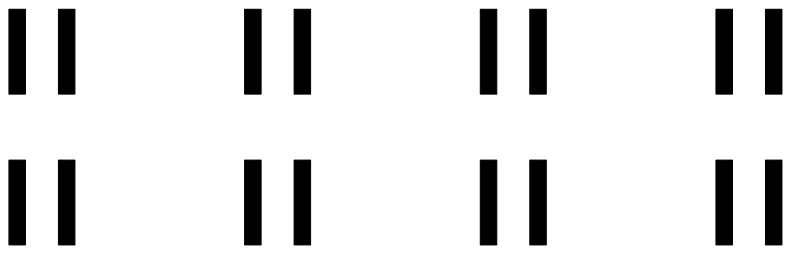
[picture p26: page 1]
