slhowe/Spiro/spirometer_design/jake_small/pdf/jake_small-B.SilkS.pdf

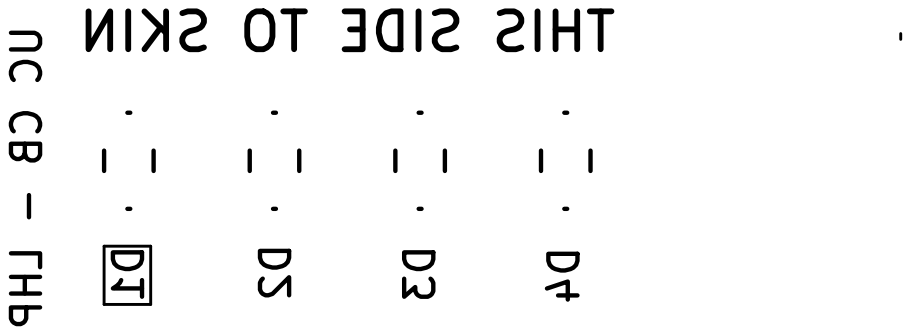
[picture p27: page 1]

UC CB - LHP THIS SIDE TO SKIND1 D2D3D4
