slhowe/Spiro/spirometer_design/jake_small/pdf/jake_small-Edge.Cuts.pdf

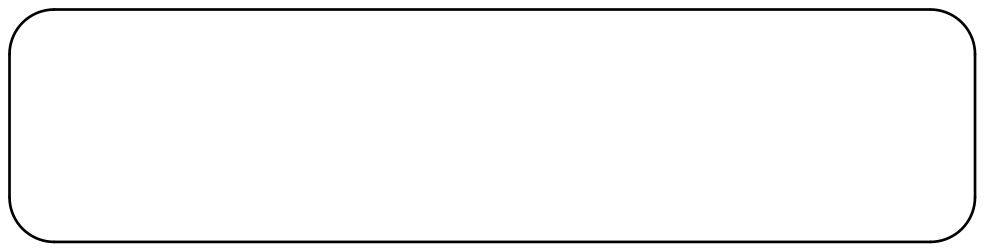
[picture p28: page 1]
