slhowe/Spiro/spirometer_design/jake_small/pdf/jake_small-F.Cu.pdf

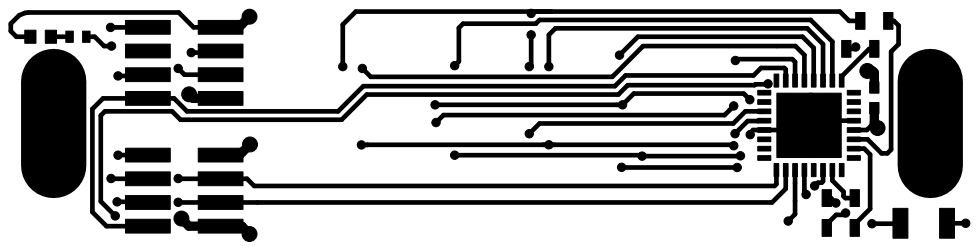
[picture p29: page 1]
