slhowe/Spiro/spirometer_design/jake_small/pdf/jake_small-F.Mask.pdf

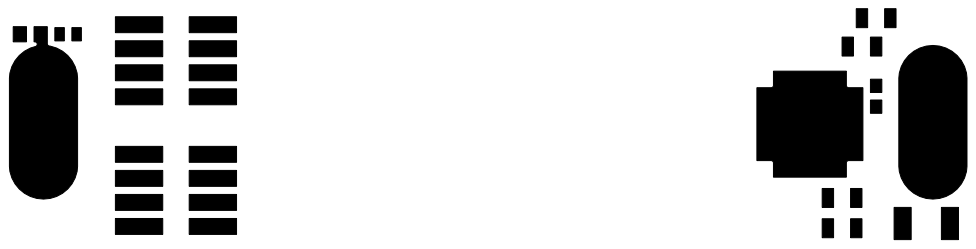
[picture p30: page 1]
