slhowe/Spiro/spirometer_design/jake_small/pdf/jake_small-F.Paste.pdf

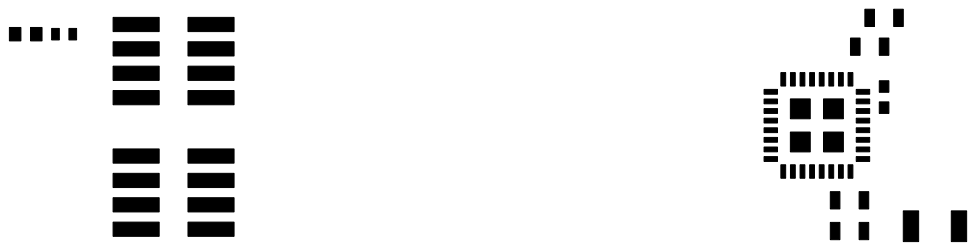
[picture p31: page 1]
