slhowe/Spiro/spirometer_design/Spiro/spiroBoard/spiroBoard.kicad_pcb

## KiCad design spirometer_design/Spiro/spiroBoard/spiroBoard.kicad_pcb (2020-03-23)

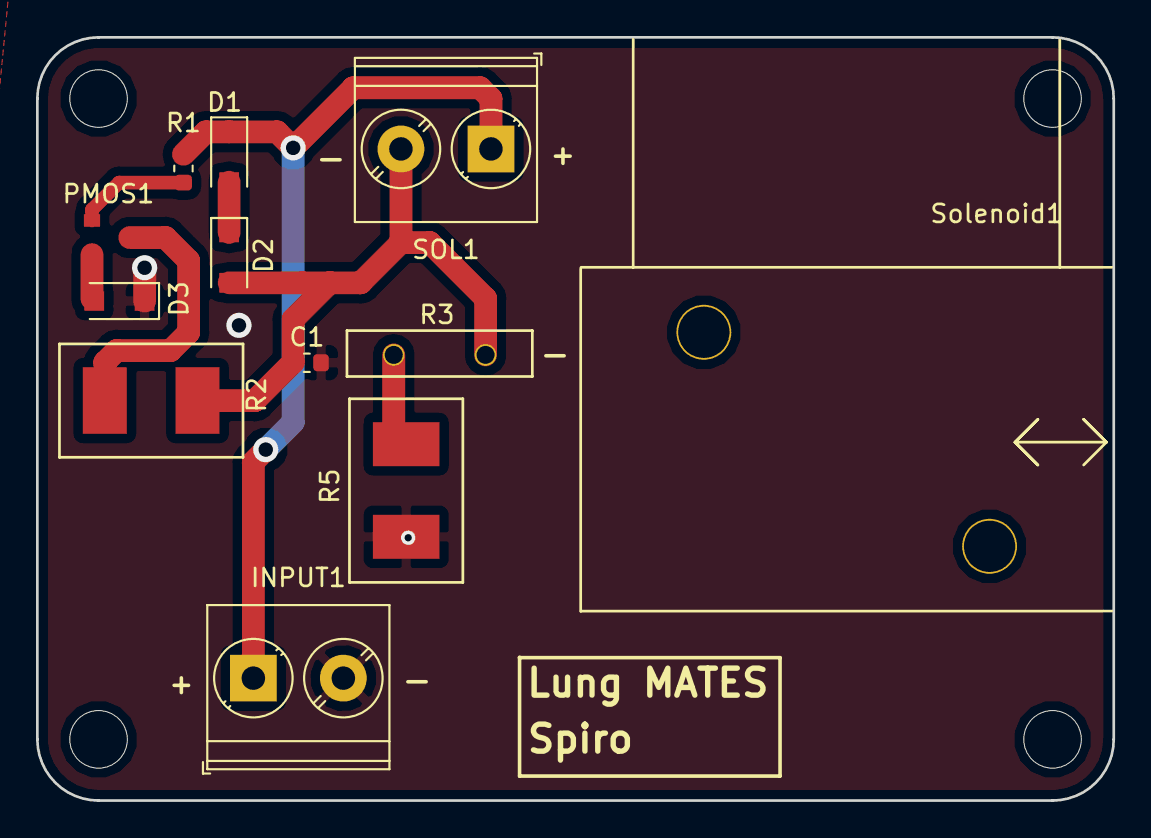
[picture p32: board spiroBoard.kicad_pcb from above]

Board: 2 copper layers, 59.8 x 42.4 mm, 16 parts (0 on the bottom side), 8 nets.

Parts:
C1: 4.7mF; C_0603_1608Metric
D1, D2, D3: 3A 100V; D_SOD-123F
H1, H2, H3, H4: MountingHole; MountingHole_3.2mm_M3
INPUT1: Screw_Terminal_01x02; TerminalBlock_Phoenix_PT-1,5-2-5.0-H_1x02_P5.00mm_Horizontal
PMOS1: RQ5E035ATTCL; TSMT3-SC-96-PMOS
R1: 22; R_0603_1608Metric
R2: 22; Resistor 2512 (6432 Metric)
R3: 4.0; PWR221T-30-RESISTOR
R5: 0.43; Resistor 2512 (6432 Metric)
SOL1: Screw_Terminal_01x02; TerminalBlock_Phoenix_PT-1,5-2-5.0-H_1x02_P5.00mm_Horizontal
Solenoid1: 5VDC 8.2W 3.2Ohm; DSOL-0630-05E-SOLENOID

Connections:
/GND: C1.2, D3.1, INPUT1.2, R5.2
/Vin: D1.1, INPUT1.1, R1.1, SOL1.1
/solenoid-: C1.1, D2.2, R2.2, R3.1, SOL1.2
unnamed: D1.2, D2.1
unnamed: D3.2, PMOS1.2
unnamed: PMOS1.1, R1.2
unnamed: PMOS1.3, R2.1
unnamed: R3.2, R5.1
