slhowe/Spiro/spirometer_design/jake_small/jake_small.kicad_pcb

## KiCad design spirometer_design/jake_small/jake_small.kicad_pcb (2020-03-23)

Schematic: jake_small.sch

Parts:
C1, C2: 100uF; C_0402
D1, D2, D3, D4: LED_Dual_CAAC; LED-4PIN-XZM2MRTNI55W
D5: LED; LED_0402
H1, H2: MountingHole; MountingHole-10x5-oval
J1, J2: Conn_01x08; Pin_Header_Straight_2x04_Pitch1.27mm_SMD
J3, J4: Conn_01x01; TP_1.6mmx0.8mm
R1: R; R_0402
R5, R7: 115R; R_0603
R6, R8: 70R; R_0603
U1: ATtiny167-MU; QFN-32-1EP_5x5mm_Pitch0.5mm

Connections:
/A_1: R6.1, U1.15 (PB6)
/A_1a: D2.2, D4.2, R7.2
/A_2: R8.1, U1.18 (XTAL2/PB5)
/A_2a: D1.2, D3.2, R5.2
/B_1: R5.1, U1.19 (XTAL1/PB4)
/B_1a: D1.3, D3.3, R8.2
/B_2: R7.1, U1.25 (PB3)
/B_2a: D2.3, D4.3, R6.2
/C1: D4.4, U1.28 (PB0)
/C2: D4.1, U1.12 (AREF/PA7)
/C3: D3.4, U1.27 (PB1)
/C4: D3.1, U1.3 (PA3)
/C5: D2.4, U1.26 (PB2)
/C6: D2.1, U1.30 (PA1)
/C7: D1.1, D1.4, U1.29 (PA0)
/MISO: J1.2, J2.2, U1.31 (PA2)
/MOSI: J1.5, J2.5, U1.9 (PA4)
/SCK: J1.3, J2.3, U1.10 (PA5)
/nRES: J3.1, U1.14 (~RESET~/PB7)
/nSS: J2.4, U1.11 (PA6)
/nSS1: J1.8, J2.6
/nSS3: J1.4, J2.8
GND: C1.2, C2.2, D5.1 (K), J1.7, J2.7, J4.1, U1.5 (AGND), U1.21 (GND), U1.33 (GND)
unnamed: D5.2 (A), R1.1
VCC: C1.1, C2.1, J1.1, J2.1, R1.2, U1.4 (AVCC), U1.20 (VCC)

Notes on the sheet:
This is the one that we can't sample

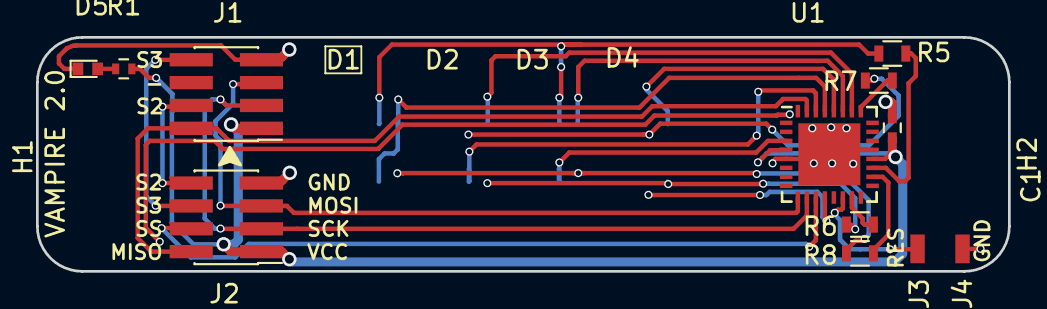
[picture p33: board jake_small.kicad_pcb from above]

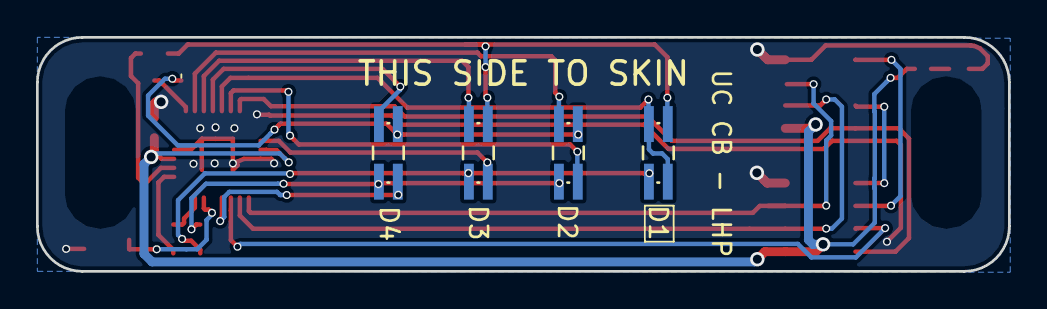
[picture p34: board jake_small.kicad_pcb from below]

Board: 2 copper layers, 54.0 x 13.0 mm, 18 parts (4 on the bottom side), 25 nets.
