slhowe/Spiro/spirometer_design/Spiro/spiroBoard/baseBoard.kicad_pcb

## KiCad design spirometer_design/Spiro/spiroBoard/baseBoard.kicad_pcb (2020-03-23)

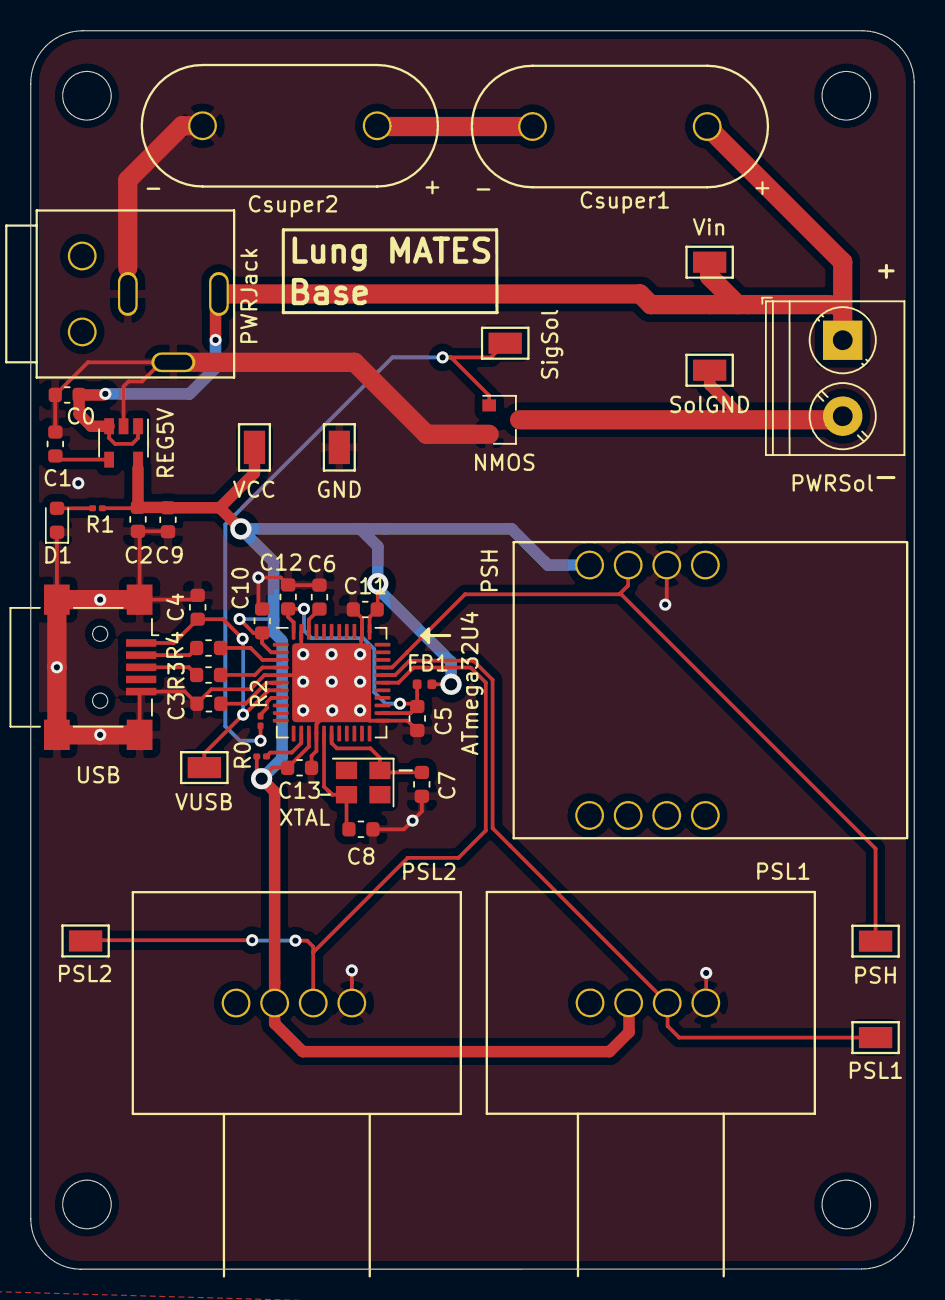
[picture p35: board baseBoard.kicad_pcb from above]

Board: 2 copper layers, 58.2 x 81.5 mm, 46 parts (0 on the bottom side), 23 nets.

Parts:
ATmega32U4: ATmega32U4-MU; QFN-44-1EP_7x7mm_P0.5mm_EP5.2x5.2mm
C0, C3, C6: 1uF; C_0603_1608Metric
C1: 470pF; C_0603_1608Metric
C2: 2.2uF; C_0603_1608Metric
C4: 10uF; C_0603_1608Metric
C5: 100nF; C_0603_1608Metric
C7, C8: 22pF; C_0603_1608Metric
C9, C10, C11, C12, C13: 0.1uF; C_0603_1608Metric
Csuper1, Csuper2: 1F; SCMR18H105PRBB0-SuperCap1F
D1: LED; LED_0603_1608Metric
FB1: Ferrite_Bead; R_0402_1005Metric
GND: TestPoint; testPoint-2.2x1.4
H1, H2, H3, H4: MountingHole; MountingHole_3.2mm_M3
NMOS: 2N7002; SOT-23
PSH: ASDXRRX001PDAA5; ASDXRRX001PDAA5-PressureSensor
PSH#2: TestPoint; testPoint-2.2x1.4
PSL1, PSL2: SSCSNBN001NDAA5
PSL1#2, PSL2#2: TestPoint; testPoint-2.2x1.4
PWRJack: Barrel_Jack_Switch; PJ-025-powerJack
PWRSol: Screw_Terminal_01x02; TerminalBlock_Phoenix_PT-1,5-2-5.0-H_1x02_P5.00mm_Horizontal
R0, R1, R2: 1K; R_0201_0603Metric
R3, R4: 22; R_0603_1608Metric
REG5V: MIC5219YM5; SOT-23-5
SigSol: TestPoint; testPoint-2.2x1.4
SolGND: TestPoint; testPoint-2.2x1.4
USB: USB_B_Mini; USB_Mini-B_Lumberg_2486_01_Horizontal
VCC: TestPoint; testPoint-2.2x1.4
VUSB: TestPoint; testPoint-2.2x1.4
Vin: TestPoint; testPoint-2.2x1.4
XTAL: 16MHz; Crystal_SMD_SeikoEpson_TSX3225-4Pin_3.2x2.5mm

Connections:
/AREF: ATmega32U4.42, C6.1
/AVCC: ATmega32U4.24, ATmega32U4.44, C5.1, C12.1, FB1.2
/D+: ATmega32U4.4, R3.1
/D-: ATmega32U4.3, R4.2
/PressureSensorHigh: ATmega32U4.30, PSH.2, PSH#2.1
/PressureSensorLow1: ATmega32U4.29, PSL1.3, PSL1#2.1
/PressureSensorLow2: ATmega32U4.28, PSL2.3, PSL2#2.1
/VCC: ATmega32U4.2, ATmega32U4.14, ATmega32U4.34, C2.1, C9.1, C10.1, C11.1, C13.1, FB1.1, PSH.1, PSL1.2, PSL2.2, R0.2, R1.2, REG5V.5, VCC.1
/VUSB: ATmega32U4.7, C4.1, USB.1, VUSB.1
/Vin: C0.1, Csuper1.1, PWRJack.1, PWRSol.1, REG5V.1, REG5V.3, Vin.1
/solenoidGND: NMOS.3, PWRSol.2, SolGND.1
/solenoidToggle: ATmega32U4.8, R2.2
GND: ATmega32U4.5, ATmega32U4.15, ATmega32U4.23, ATmega32U4.35, ATmega32U4.43, ATmega32U4.45, C0.2, C1.2, C2.2, C3.2, C4.2, C5.2, C6.2, C7.1, C8.2, C9.2, C10.2, C11.2, C12.2, C13.2, Csuper2.2, D1.1, GND.1, NMOS.2, PSH.3, PSL1.4, PSL2.4, PWRJack.2, PWRJack.3, REG5V.2, USB.5, USB.6
unnamed: C1.1, REG5V.4
unnamed: ATmega32U4.6, C3.1
unnamed: ATmega32U4.17, C7.2, XTAL.1
unnamed: ATmega32U4.16, C8.1, XTAL.2
unnamed: Csuper1.2, Csuper2.1
unnamed: D1.2, R1.1
unnamed: R4.1, USB.2
unnamed: R3.2, USB.3
unnamed: NMOS.1, R2.1, SigSol.1
unnamed: ATmega32U4.13, R0.1
