slhowe/Spiro/spirometer_design/Spiro/spiroBoardV2/spiroBoardV2.kicad_pcb

## KiCad design spirometer_design/Spiro/spiroBoardV2/spiroBoardV2.kicad_pcb (2020-03-15)

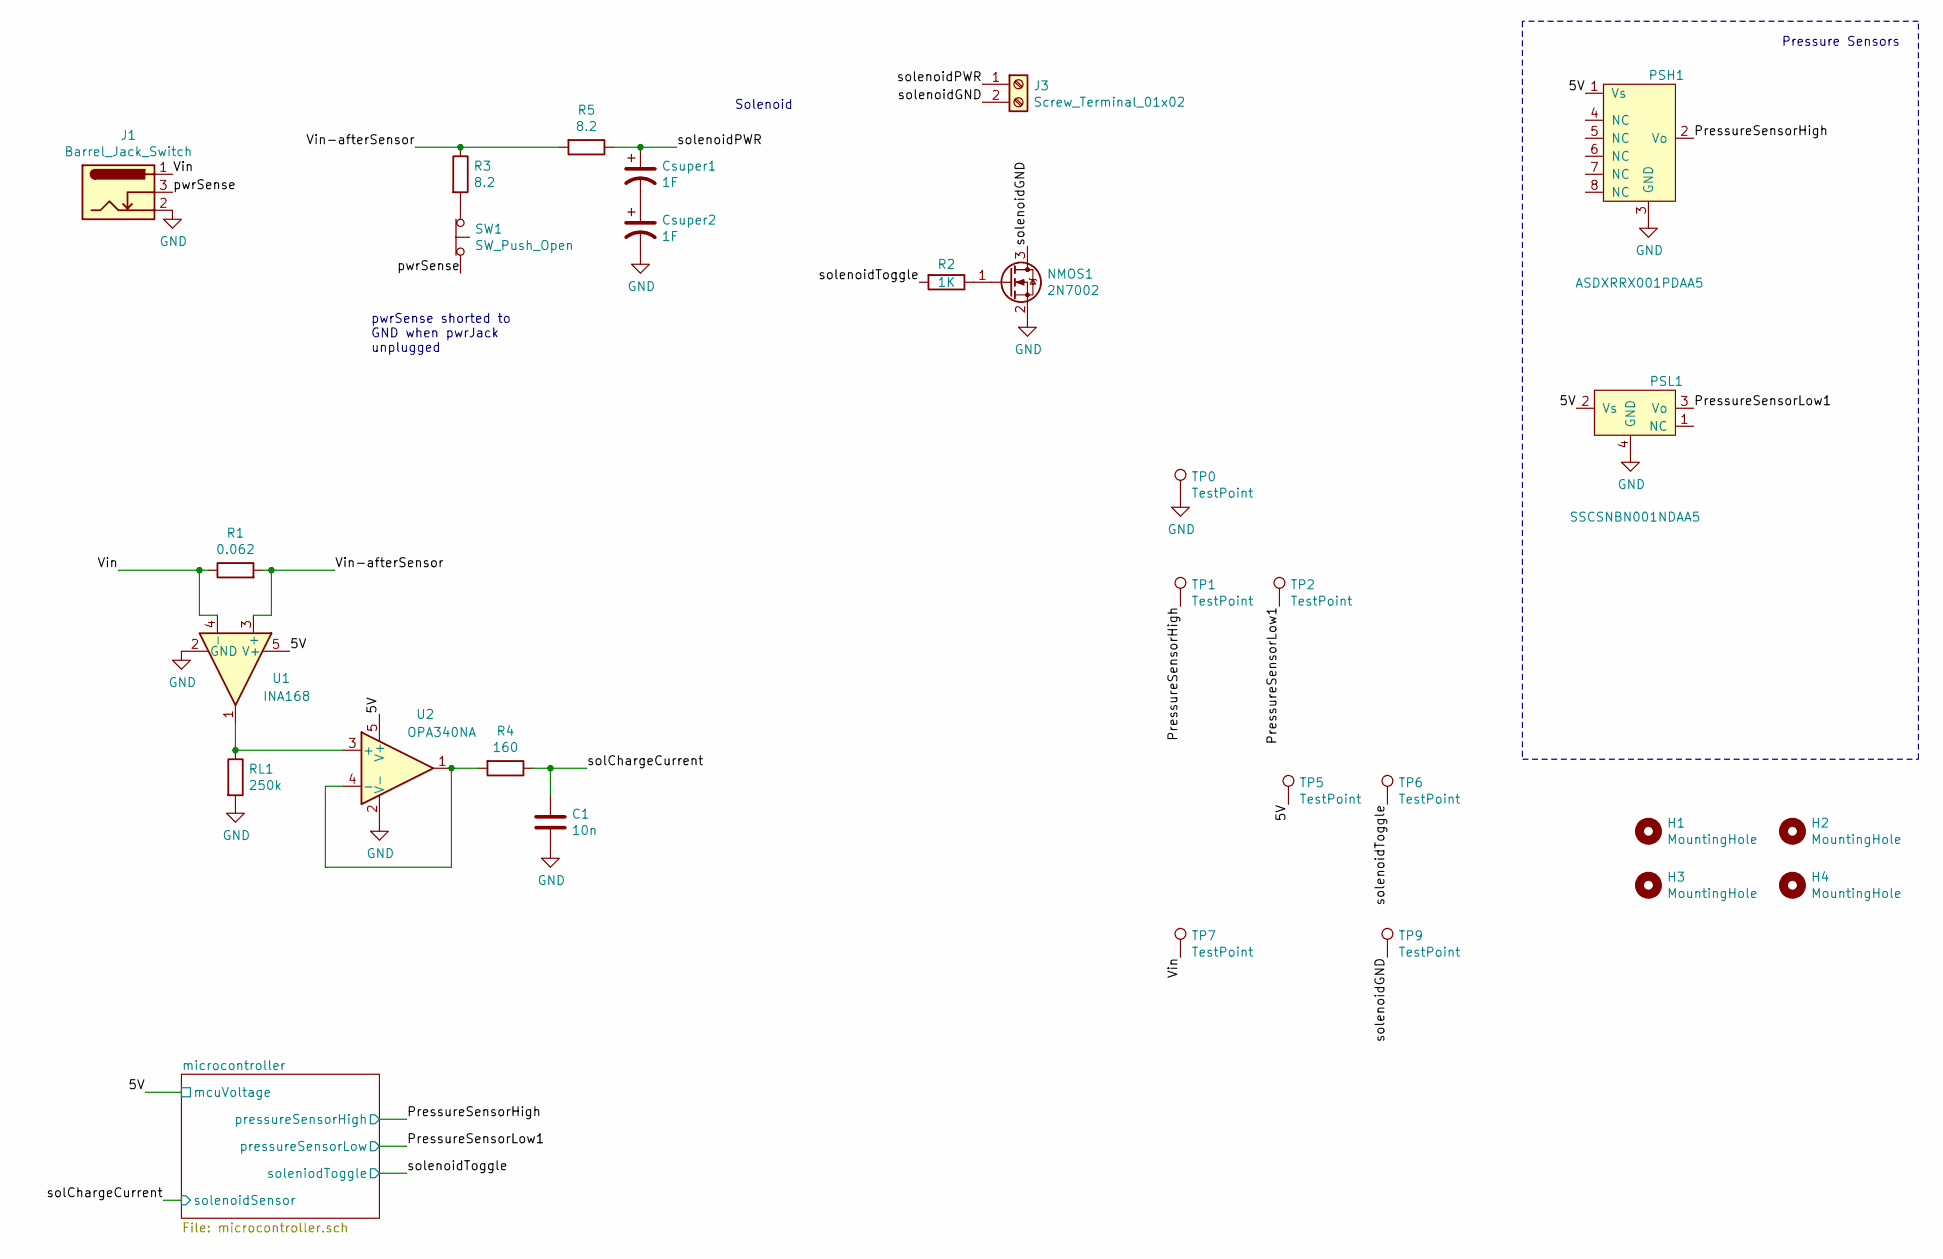
[picture p36: schematic spiroBoardV2.sch, Solenoid]

Parts:
C1: 10n; R_0603_1608Metric_Pad1.05x0.95mm_HandSolder
Csuper1, Csuper2: 1F; SCMR18H105PRBB0-SuperCap1F
H1, H2, H3, H4: MountingHole; MountingHole_3.2mm_M3
J1: Barrel_Jack_Switch; BarrelJack_Wuerth_6941xx301002
J3: Screw_Terminal_01x02; TerminalBlock_Phoenix_PT-1,5-2-5.0-H_1x02_P5.00mm_Horizontal
NMOS1: 2N7002; SOT-23
PSH1: ASDXRRX001PDAA5; ASDXRRX001PDAA5-PressureSensor
PSL1: SSCSNBN001NDAA5
R1: 0.062; R_1206_3216Metric_Pad1.42x1.75mm_HandSolder
R2: 1K; R_0603_1608Metric_Pad1.05x0.95mm_HandSolder
R3, R5: 8.2; TO-220-2_Vertical
R4: 160; R_1206_3216Metric_Pad1.42x1.75mm_HandSolder
RL1: 250k; R_0603_1608Metric_Pad1.05x0.95mm_HandSolder
SW1: SW_Push_Open; Slide_Switch_SPST_Through_Hole
TP0, TP1, TP2, TP5, TP6, TP7, TP9: TestPoint; testPoint-2.2x1.4
U1: INA168; SOT-23-5
U2: OPA340NA; SOT-23-5

Connections:
/5V: PSH1.1 (Vs), PSL1.2 (Vs), TP5.1, U1.5 (V+), U2.5 (V+); also elsewhere on the board
/PressureSensorHigh: PSH1.2 (Vo), TP1.1; also elsewhere on the board
/PressureSensorLow1: PSL1.3 (Vo), TP2.1; also elsewhere on the board
/Vin: J1.1, R1.1, TP7.1, U1.4 (-)
/Vin-afterSensor: R1.2, R3.1, R5.2, U1.3 (+)
/pwrSense: J1.3, SW1.2 (B)
/solChargeCurrent: C1.1, R4.1; also elsewhere on the board
/solenoidGND: J3.2, NMOS1.3 (D), TP9.1
/solenoidPWR: Csuper1.1, J3.1, R5.1
/solenoidToggle: R2.2, TP6.1; also elsewhere on the board
GND: C1.2, Csuper2.2, J1.2, NMOS1.2 (S), PSH1.3 (GND), PSL1.4 (GND), RL1.2, TP0.1, U1.2 (GND), U2.2 (V-); also elsewhere on the board
unnamed: Csuper1.2, Csuper2.1
unnamed: NMOS1.1 (G), R2.1
unnamed: R3.2, SW1.1 (A)
unnamed: R4.2, U2.1, U2.4 (-)
unnamed: RL1.1, U1.1, U2.3 (+)

Notes on the sheet:
Pressure Sensors
Solenoid
pwrSense shorted to GND when pwrJack unplugged

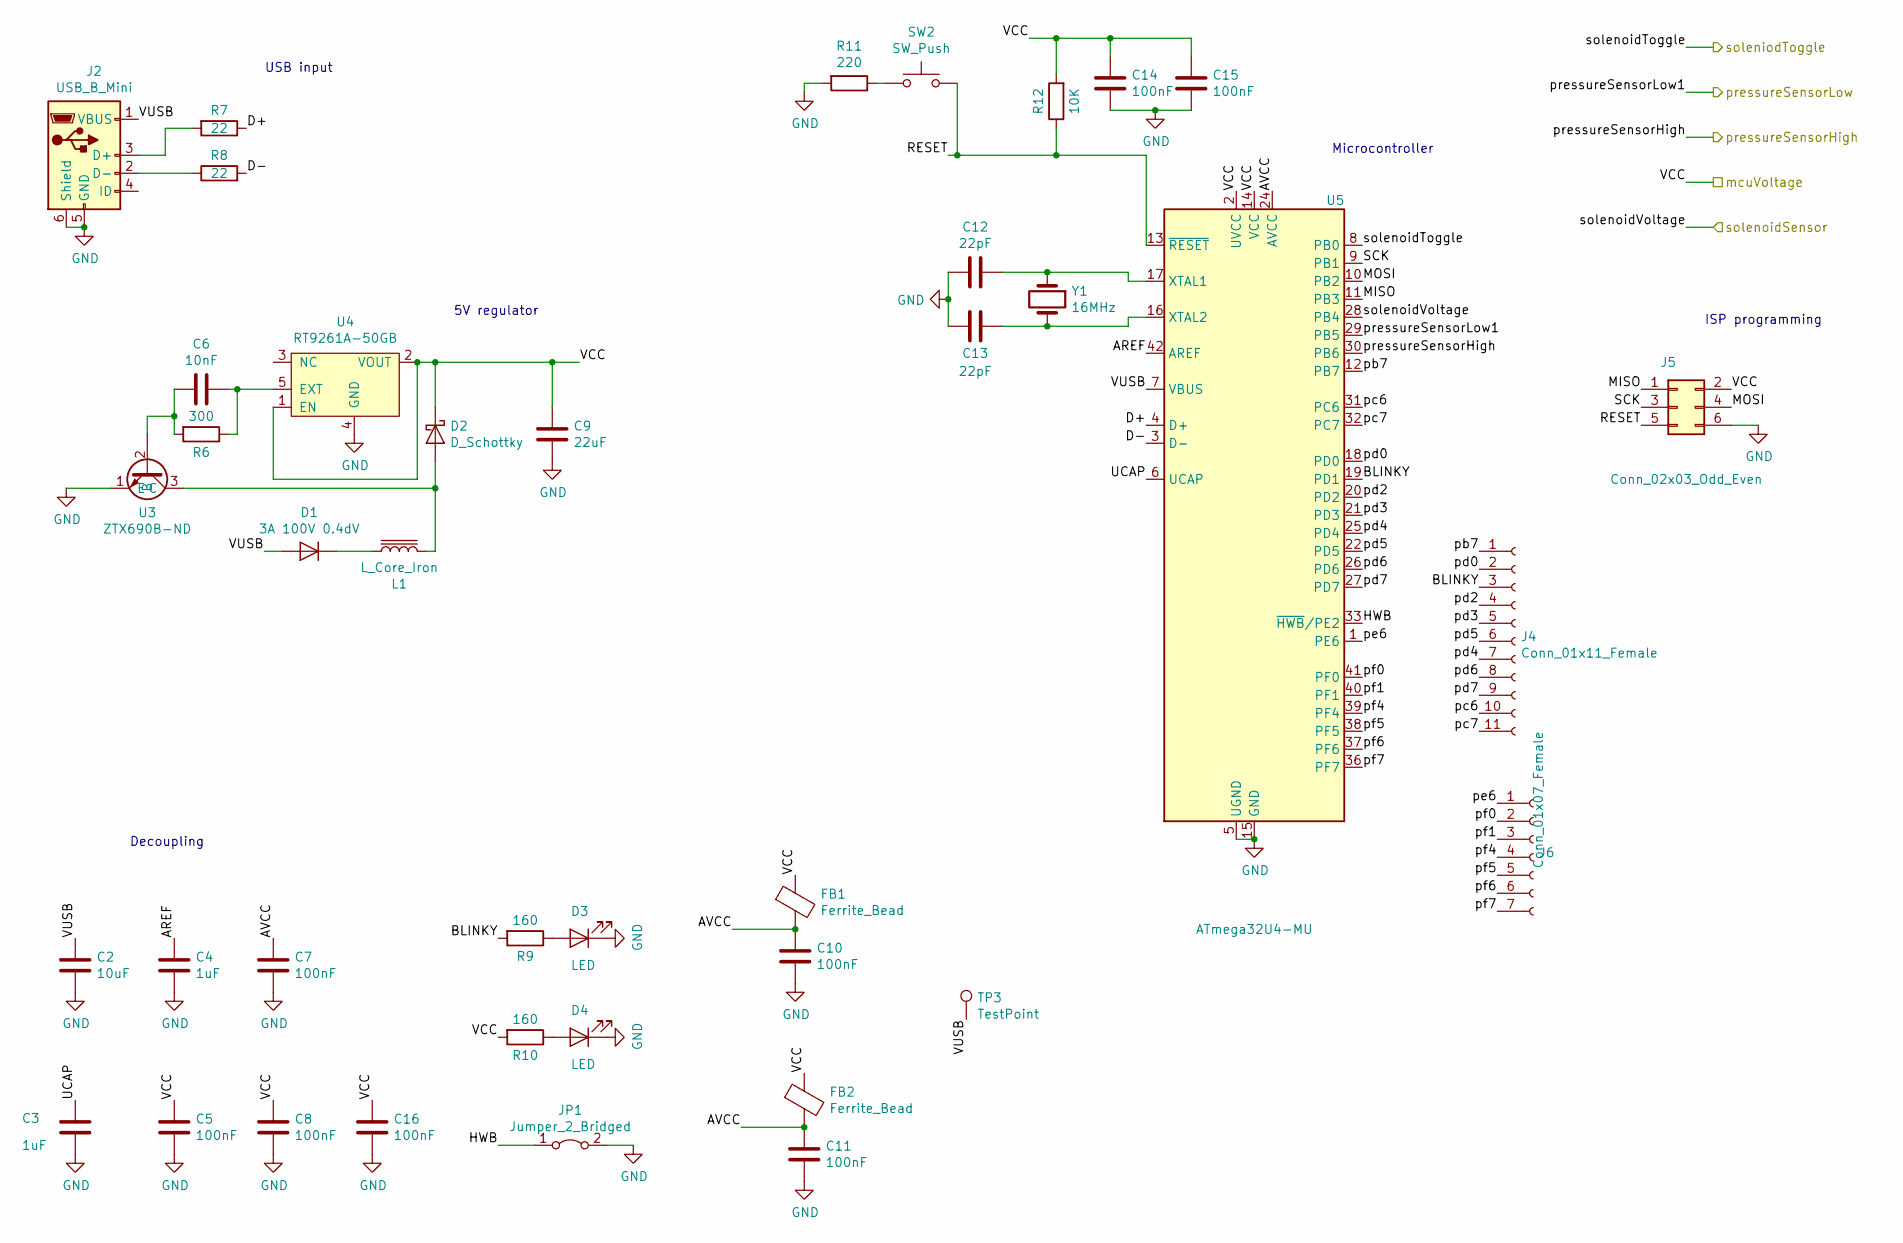
[picture p37: schematic microcontroller.sch]

Parts:
C2: 10uF; C_0603_1608Metric
C3, C4: 1uF; C_0603_1608Metric
C5, C7, C8, C10, C11, C14, C15, C16: 100nF; C_0603_1608Metric
C6: 10nF; R_0603_1608Metric_Pad1.05x0.95mm_HandSolder
C9: 22uF; R_0603_1608Metric_Pad1.05x0.95mm_HandSolder
C12, C13: 22pF; C_0603_1608Metric
D1: 3A 100V 0.4dV; D_SOD-123F
D2: D_Schottky; D_SOD-123
D3, D4: LED; LED_0603_1608Metric
FB1, FB2: Ferrite_Bead; R_0402_1005Metric
J2: USB_B_Mini; USB_Mini-B_Lumberg_2486_01_Horizontal
J4: Conn_01x11_Female; PinHeader_1x11_P2.54mm_Vertical
J5: Conn_02x03_Odd_Even; PinHeader_2x03_P2.54mm_Vertical
J6: Conn_01x07_Female; PinHeader_1x07_P2.54mm_Vertical
JP1: Jumper_2_Bridged; SolderJumper-2_P1.3mm_Bridged_Pad1.0x1.5mm
L1: L_Core_Iron; PA4334.273NLT
R6: 300; R_0603_1608Metric_Pad1.05x0.95mm_HandSolder
R7, R8: 22; R_0603_1608Metric
R9, R10: 160; R_0603_1608Metric_Pad1.05x0.95mm_HandSolder
R11: 220; R_0603_1608Metric_Pad1.05x0.95mm_HandSolder
R12: 10K; R_0603_1608Metric_Pad1.05x0.95mm_HandSolder
SW2: SW_Push; Switch_Tactile_SMD_6x6mm_PTS645
TP3: TestPoint; testPoint-2.2x1.4
U3: ZTX690B-ND; TO-92L_Inline
U4: RT9261A-50GB; SOT-23-5_HandSoldering
U5: ATmega32U4-MU; QFN-44-1EP_7x7mm_P0.5mm_EP5.2x5.2mm
Y1: 16MHz; Crystal_SMD_SeikoEpson_TSX3225-4Pin_3.2x2.5mm

Connections:
/5V: C5.1, C8.1, C9.1, C14.1, C15.1, C16.1, D2.1 (K), FB1.1, FB2.1, J5.2, R10.2, R12.2, U4.1 (EN), U4.2 (VOUT), U5.2 (UVCC), U5.14 (VCC), U5.34 (VCC); also elsewhere on the board
/PressureSensorHigh: U5.30 (PB6); also elsewhere on the board
/PressureSensorLow1: U5.29 (PB5); also elsewhere on the board
/microcontroller/AREF: C4.1, U5.42 (AREF)
/microcontroller/AVCC: C7.1, C10.1, C11.1, FB1.2, FB2.2, U5.24 (AVCC), U5.44 (AVCC)
/microcontroller/BLINKY: J4.3, R9.2, U5.19 (PD1)
/microcontroller/D+: R7.1, U5.4 (D+)
/microcontroller/D-: R8.2, U5.3 (D-)
/microcontroller/HWB: JP1.1 (A), U5.33 (~HWB~/PE2)
/microcontroller/MISO: J5.1, U5.11 (PB3)
/microcontroller/MOSI: J5.4, U5.10 (PB2)
/microcontroller/RESET: J5.5, R12.1, SW2.1, U5.13 (~RESET)
/microcontroller/SCK: J5.3, U5.9 (PB1)
/microcontroller/UCAP: C3.1, U5.6 (UCAP)
/microcontroller/VUSB: C2.1, D1.2 (A), J2.1 (VBUS), TP3.1, U5.7 (VBUS)
/microcontroller/pb7: J4.1, U5.12 (PB7)
/microcontroller/pc6: J4.10, U5.31 (PC6)
/microcontroller/pc7: J4.11, U5.32 (PC7)
/microcontroller/pd0: J4.2, U5.18 (PD0)
/microcontroller/pd2: J4.4, U5.20 (PD2)
/microcontroller/pd3: J4.5, U5.21 (PD3)
/microcontroller/pd4: J4.7, U5.25 (PD4)
/microcontroller/pd5: J4.6, U5.22 (PD5)
/microcontroller/pd6: J4.8, U5.26 (PD6)
/microcontroller/pd7: J4.9, U5.27 (PD7)
/microcontroller/pe6: J6.1, U5.1 (PE6)
/microcontroller/pf0: J6.2, U5.41 (PF0)
/microcontroller/pf1: J6.3, U5.40 (PF1)
/microcontroller/pf4: J6.4, U5.39 (PF4)
/microcontroller/pf5: J6.5, U5.38 (PF5)
/microcontroller/pf6: J6.6, U5.37 (PF6)
/microcontroller/pf7: J6.7, U5.36 (PF7)
/solChargeCurrent: U5.28 (PB4); also elsewhere on the board
/solenoidToggle: U5.8 (PB0); also elsewhere on the board
GND: C2.2, C3.2, C4.2, C5.2, C7.2, C8.2, C9.2, C10.2, C11.2, C12.1, C13.2, C14.2, C15.2, C16.2, D3.1 (K), D4.1 (K), J2.5 (GND), J2.6 (Shield), J5.6, JP1.2 (B), R11.2, U3.1 (E), U4.4 (GND), U5.5 (UGND), U5.15 (GND), U5.23 (GND), U5.35 (GND), U5.43 (GND), U5.45 (GND); also elsewhere on the board
unnamed: C6.1, R6.1, U4.5 (EXT)
unnamed: C6.2, R6.2, U3.2 (B)
unnamed: C12.2, U5.17 (XTAL1), Y1.1
unnamed: C13.1, U5.16 (XTAL2), Y1.2
unnamed: D1.1 (K), L1.1
unnamed: D2.2 (A), L1.2, U3.3 (C)
unnamed: D3.2 (A), R9.1
unnamed: D4.2 (A), R10.1
unnamed: J2.2 (D-), R8.1
unnamed: J2.3 (D+), R7.2
unnamed: R11.1, SW2.2

Notes on the sheet:
Microcontroller
5V regulator
USB input
Decoupling
ISP programming

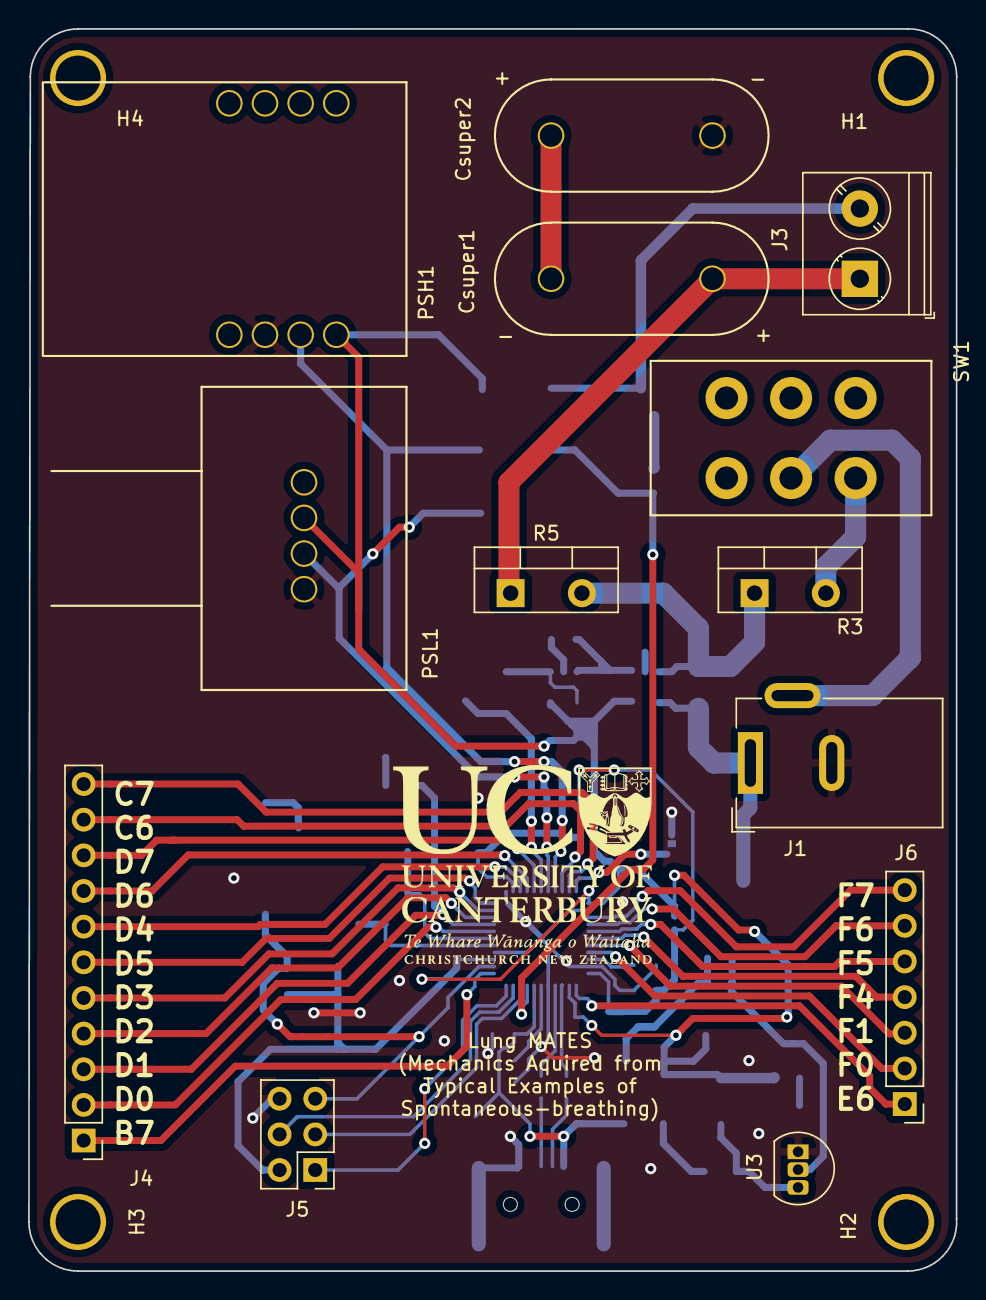
[picture p38: board spiroBoardV2.kicad_pcb from above]

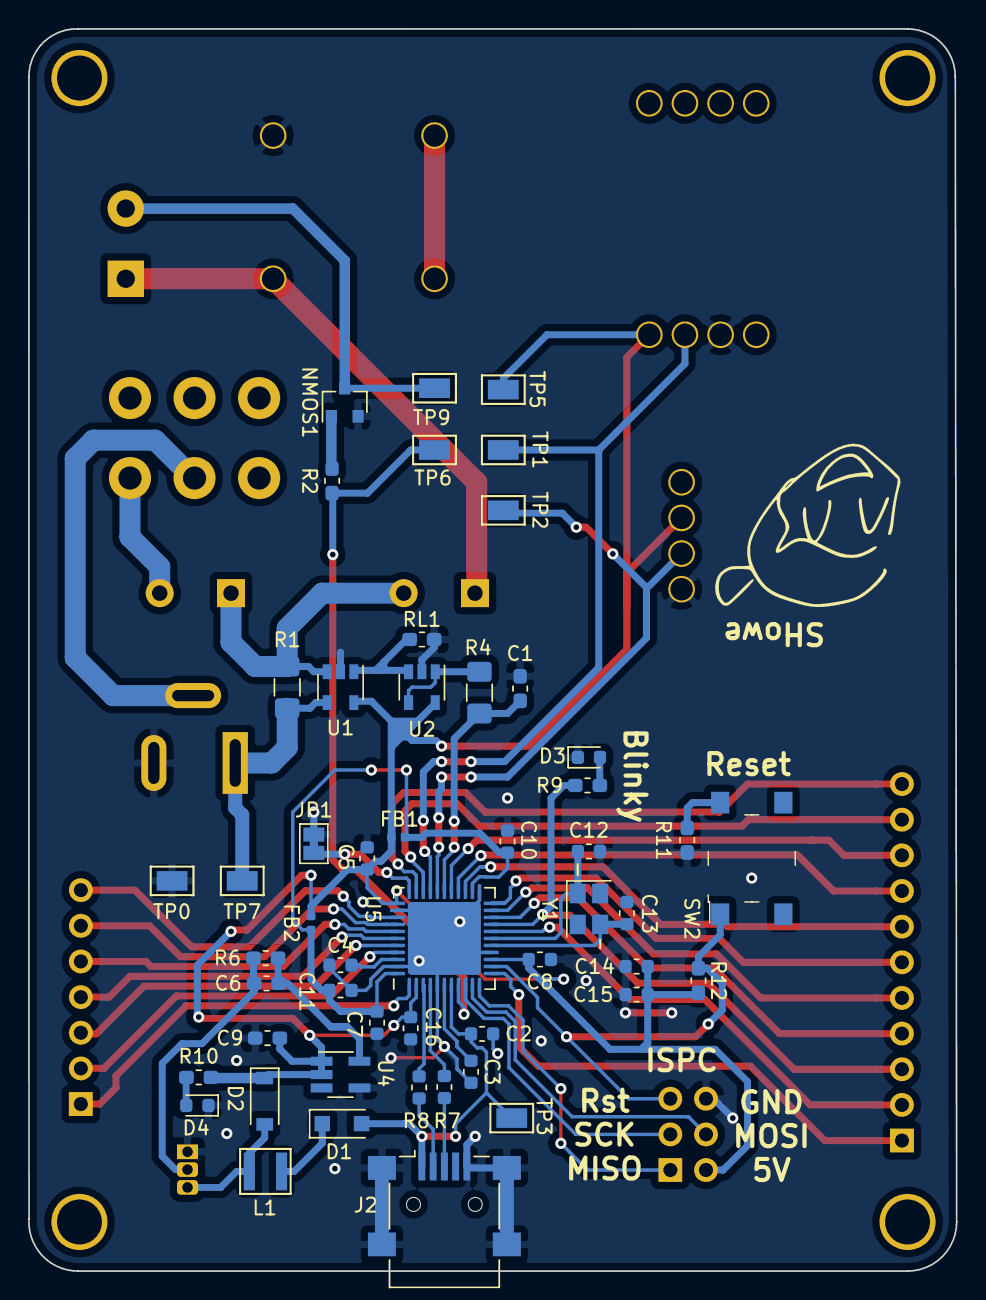
[picture p39: board spiroBoardV2.kicad_pcb from below]

Board: 2 copper layers, 66.1 x 88.5 mm, 68 parts (51 on the bottom side), 56 nets.
