slhowe/Spiro/python/shuttering/validationShutter/plot_basics.py

#!/bin/bash

# Import my extensions
import sys
sys.path.insert(0, '/home/sarah/Documents/Spirometry/python/extensions')

import csv
import matplotlib.pyplot as plt
from data_struct import DataStore as Data
from calculus import integral

path = './'
files = [
        'data_recording.csv'
         ]

# Create data classes
reset = Data('reset')
reset.clear_dataset_registry()

for i in range(len(files)):
    # Store pressure and flow data
    dataset = Data('dataset_1')
    filename = path + files[i]
    with open(filename, 'rb') as csvfile:
        reader = csv.reader(csvfile, delimiter = ',')

        # skip header line
        header = reader.next()

        for row in reader:
            pressure = float(row[2])
            flow = float(row[1])
            time = float(row[3])

            dataset.pressure.append(pressure)
            dataset.flow.append(flow)
            dataset.time.append(time)


#    plt.plot(dataset.time, dataset.pressure, 'b',
#             dataset.time, dataset.flow, 'r',
#             )
    volume = integral(dataset.flow, 300)
    a, (ax1, ax2) = plt.subplots(2, sharex=True)
    ax1.plot(dataset.time, dataset.pressure, 'b')
    ax2.plot(dataset.time, dataset.flow, 'r',
             dataset.time, volume, 'm',
             )

    ax1.grid()
    ax2.grid()
    ax1.legend(["Pressure"])
    ax2.legend(["Flow",
                "integral of flow",
                ])
    plt.show()
