slhowe/Spiro/python/real_time_plotting/queue_manager.py

import Queue

"""
Functions to deal with taking data from queue

get_queue_item returns first item from queue
(queue default is FIFO)

get_all_queue_items returns all items in the
queue
"""

def get_queue_item(queue_object):
    try:
        item = queue_object.get(True, 0.05)
    except Queue.Empty:
        print('Delay in reading queue')
        return None
    return item

def clear_queue(queue_object):
    while True:
        try:
            yield q.get_nowait()
        except Queue.Empty:
            break

def get_all_queue_items(queue_object):
    pass
