slhowe/Spiro/(commit log)

2016-04-20 "Now fitting LSQ to a %age of flow drop"
2016-04-21 Shifted the flow data as though a new resistance was added
2016-04-21 Looking at if a new resistence can be extracted, even if noisy
2016-04-22 error condition on first data point in filtering section
2016-04-22 New file made. Seeing if anything can be found from shifted pressure
2016-04-29 e and r calc works with error for test case. Now looking at exp and insp
2016-08-18 Added new files
    [calibration_table.csv]
2016-09-22 Add hamming LP filter
2016-09-22 Add arduino code for spirometer
2016-09-29 Add filtering to split breaths function
2016-10-10 Estimation of pressure data from flow
2016-10-10 filtering data with hamming low pass filter
2016-10-11 Presure estimation as function. Need to try iteratively estimating pressure. Current estimation is ok but doesn.t capture small changes. Has large error in some places.
2016-10-12 Function to estimate pressure. Simple method, integrate on rising flow, constant on falling flow. Additional error fixing step after initial guess; it could be iterative?
2016-10-12 Better iteration. Has max error and iteration. Pressure change each iteration depends on the iteration number, more change for lower iterations
2016-10-18 Add extensions to load pressure and flow data from .mat files
2016-10-19 sampling frequency as input to split breaths. Option to toggle data filtering in split breaths
2016-10-24 Pressure estimate and actual pressure now use different ranges as input
2016-10-25 Update how splits is plotted and increased filtering on splits
2016-11-28 Stripped back to simple plotting case
2016-12-02 Starts of a plotting tool, with threading
2016-12-06 Plotting works but is very slow. Need to put plotting in thread? is CPU hogging
2016-12-06 Plotting issue due to reading buffered serial at low frequency. Now plotting at rate set in breath_analyser, recording serial data at rate defined in serial_monitor. Max serial read frequency seems t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
    [serial_monitor.py]
2016-12-06 New threading class to analyse data
2016-12-06 Analyses expiration decay. Working for static data. Resistance found over spir + resistance by unplugging second pressure port, so always comparing to atmosphere
2016-12-07 analyser shell class now working. Currently only prints that it is alive
2018-05-18 first data
    [M01_mask_Rx.csv, M01_mask_noRx.csv, M01_mp_Rx.csv, M01_mp_noRx.csv]
2018-06-20 dump again, starting office trial analysis
    [M01_mask_Rx.csv, M01_mask_noRx.csv, M01_mp_Rx.csv, M01_mp_noRx.csv]
2018-06-29 starting on correct Ps to Pm conversion
    [data_analysis.py]
2018-07-12 resistance_calculation looking at higher range and data_analysis looking at high flow range for peak breaths
2019-09-09 looking at pressure changing
2019-09-19 fixed end target for linear fit
    [microcontroller.sch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]
2020-03-23 dump -- good luck
    [Bom_7998437.csv, NewFile1.csv, NewFile2.csv, baseBoard.kicad_pcb, baseBoard.sch, blue_flowsensor_calibration.csv, blue_flowsensor_calibration_2.csv, blue_flowsensor_calibration_3.csv]
